baioc/S4PU/docs/figures/prototyped/Fib_16.png

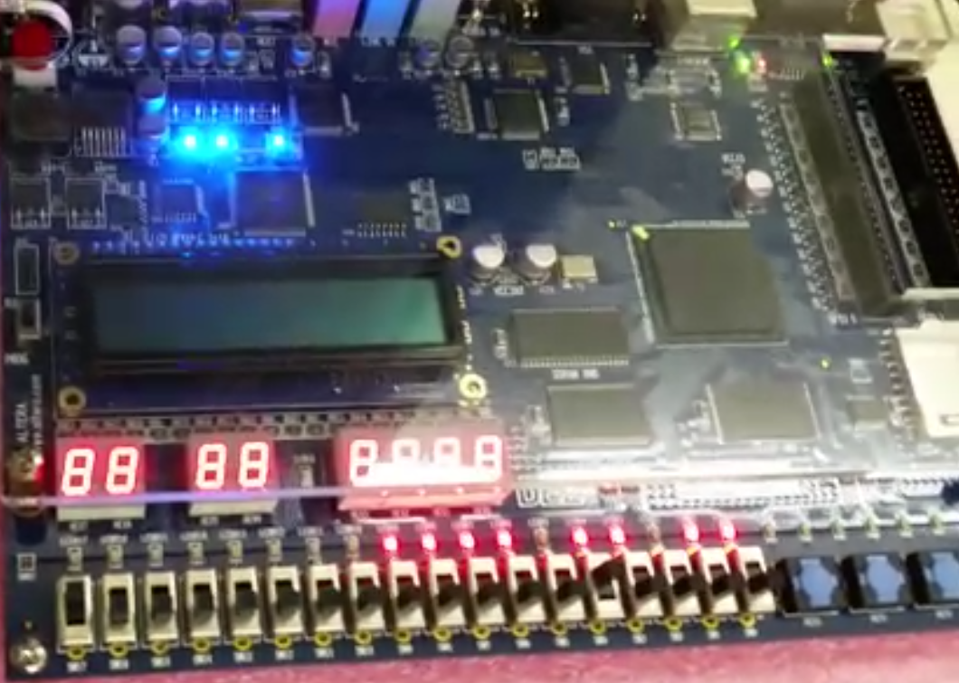
docs/figures/prototyped/Fib_16.png
