baioc/S4PU/docs/figures/prototyped/Fib_13.png

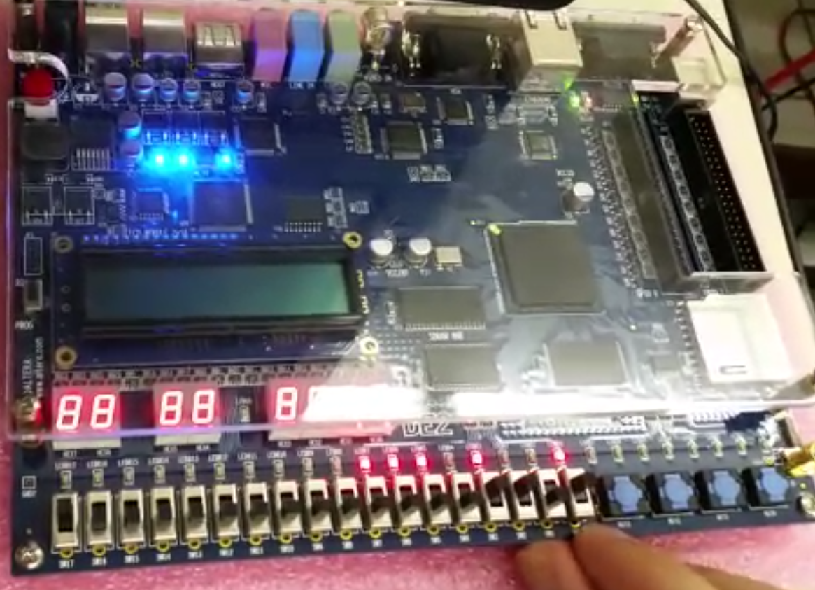
docs/figures/prototyped/Fib_13.png
