baioc/S4PU/docs/figures/draw/ALU.png

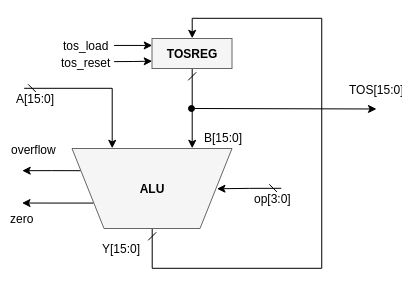
docs/figures/draw/ALU.png
