baioc/S4PU/docs/figures/draw/Datapath.png

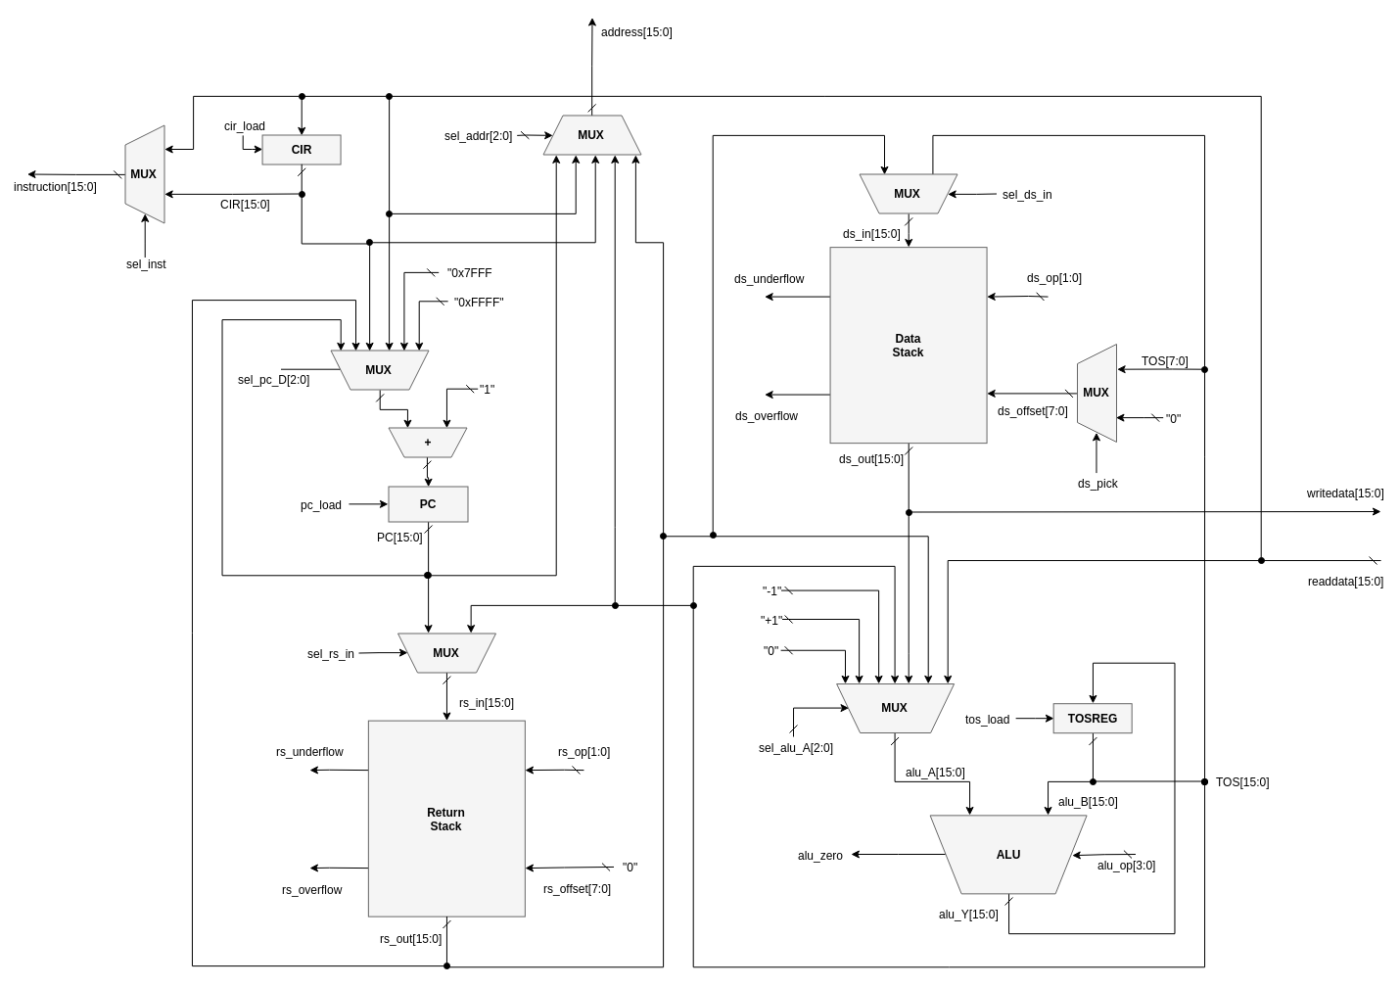
docs/figures/draw/Datapath.png
