baioc/S4PU/docs/figures/draw/FSMD.png

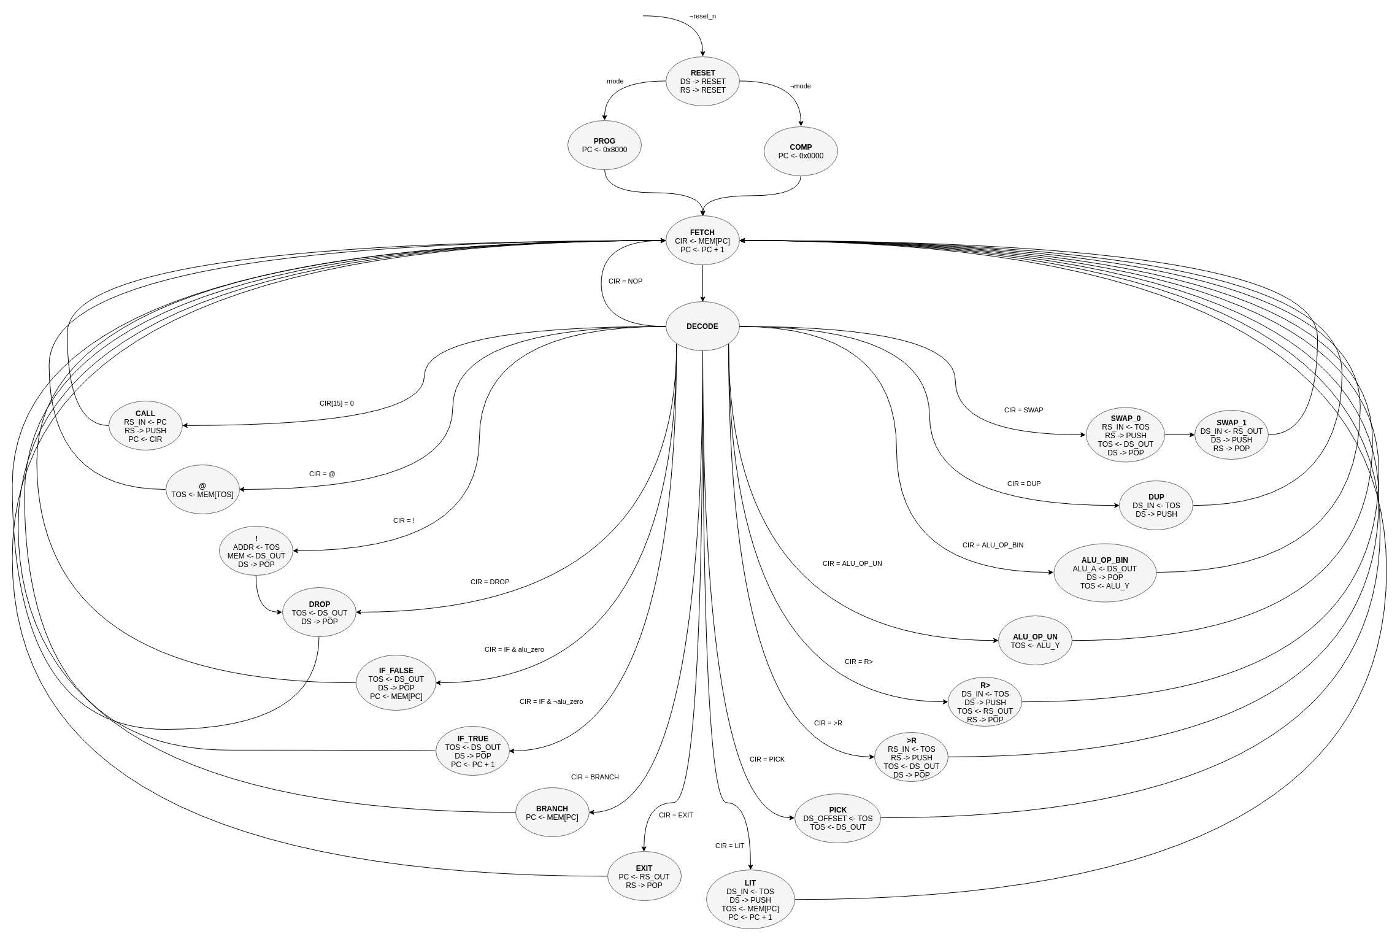
docs/figures/draw/FSMD.png
