baioc/S4PU/docs/figures/draw/Regs.png

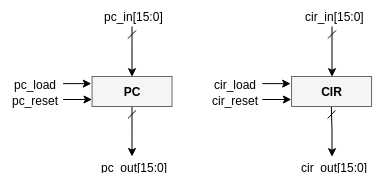
docs/figures/draw/Regs.png
