baioc/S4PU/docs/figures/draw/Stack.png

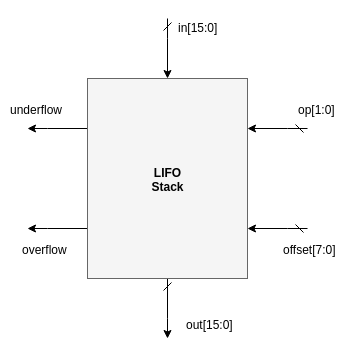
docs/figures/draw/Stack.png
