baioc/S4PU/docs/figures/draw/System.png

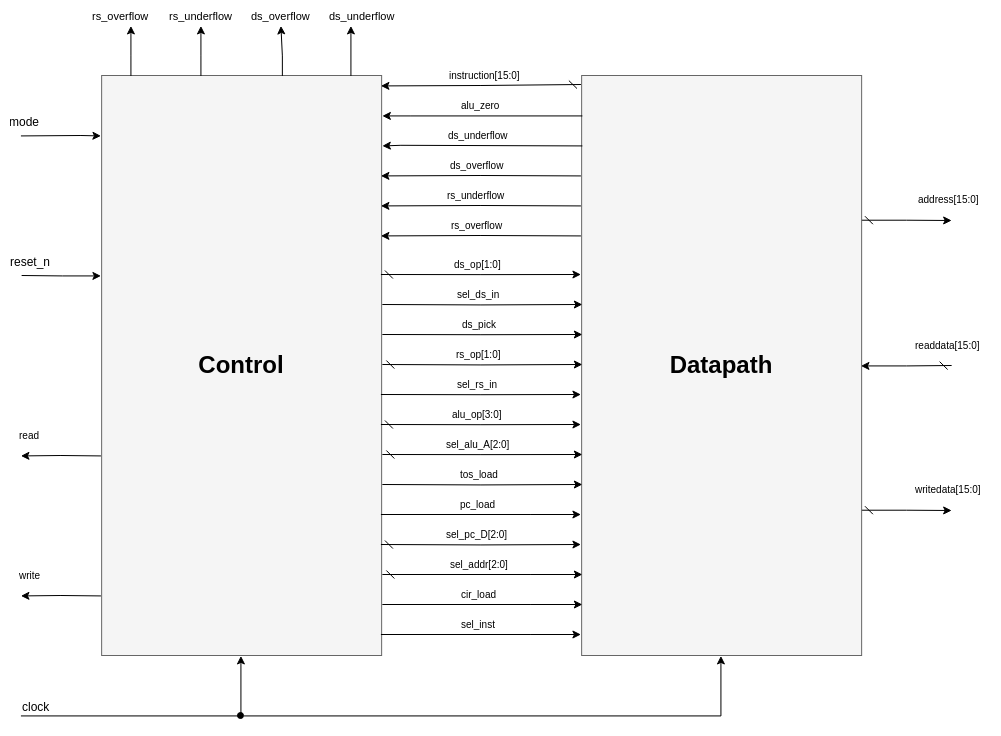
docs/figures/draw/System.png
