baioc/S4PU/docs/figures/misc/S4PU160VHD.png

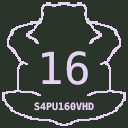
docs/figures/misc/S4PU160VHD.png
