baioc/S4PU/docs/figures/misc/s4pu.png

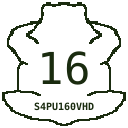
docs/figures/misc/s4pu.png
