baioc/S4PU/docs/figures/simulated/CTRL-SIM-0.png

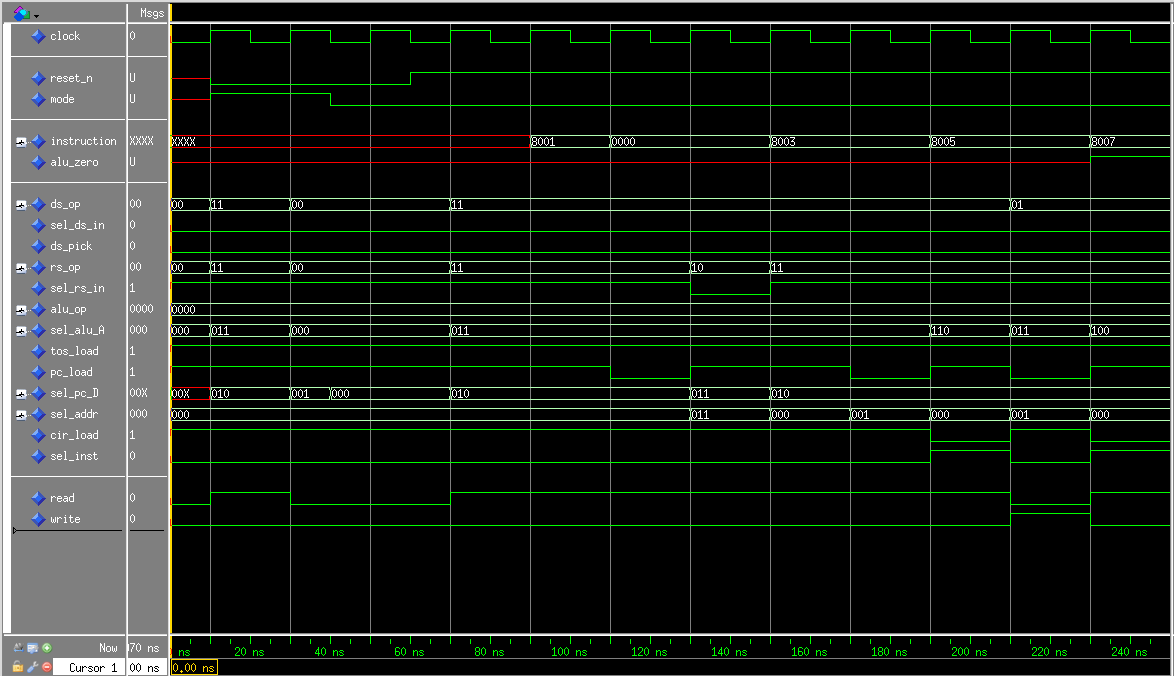
docs/figures/simulated/CTRL-SIM-0.png
