baioc/S4PU/docs/figures/simulated/CTRL-SIM-1.png

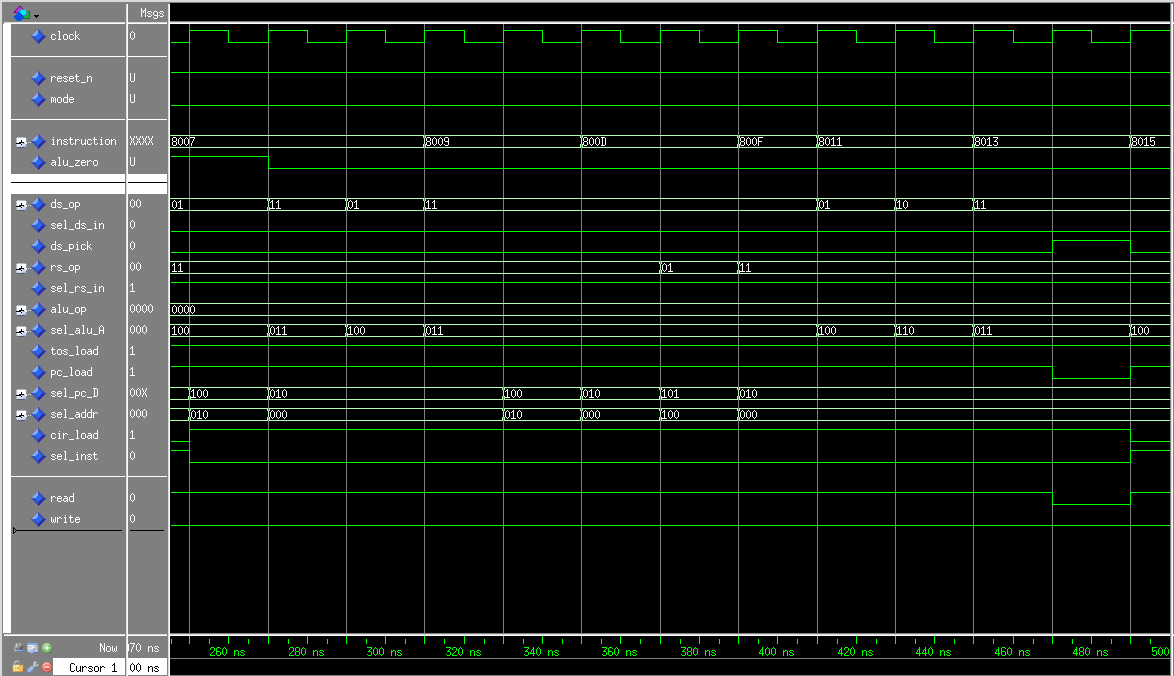
docs/figures/simulated/CTRL-SIM-1.png
