baioc/S4PU/docs/figures/simulated/CTRL-SIM-2.png

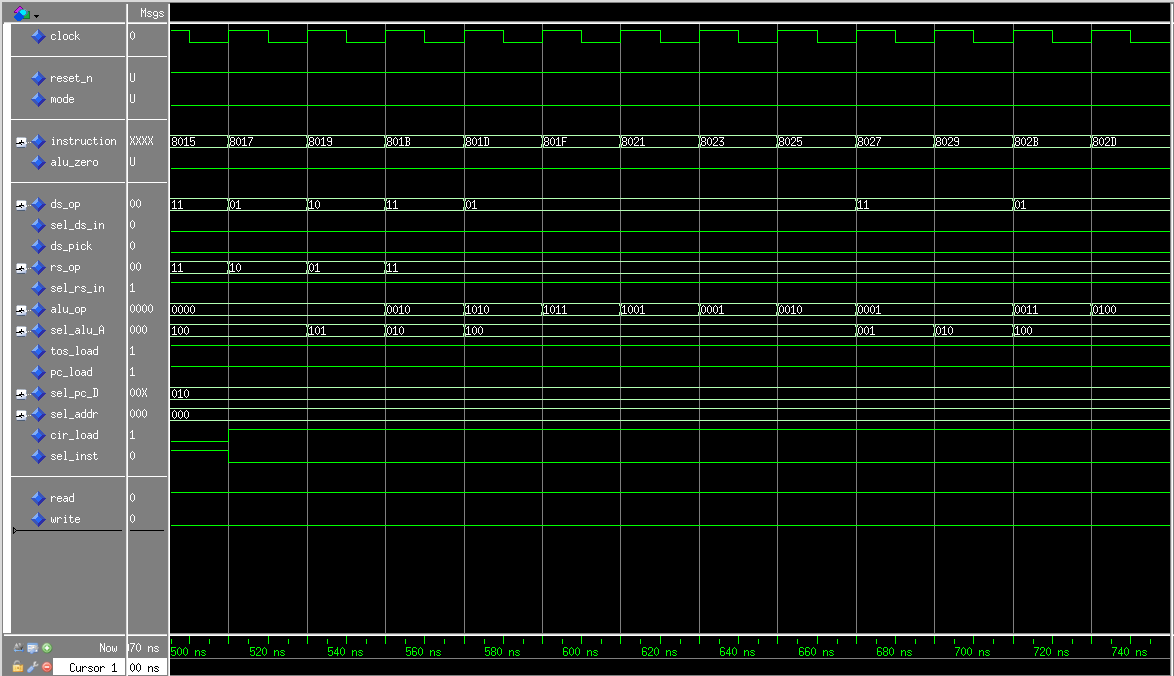
docs/figures/simulated/CTRL-SIM-2.png
