baioc/S4PU/docs/figures/simulated/CTRL-SIM-3.png

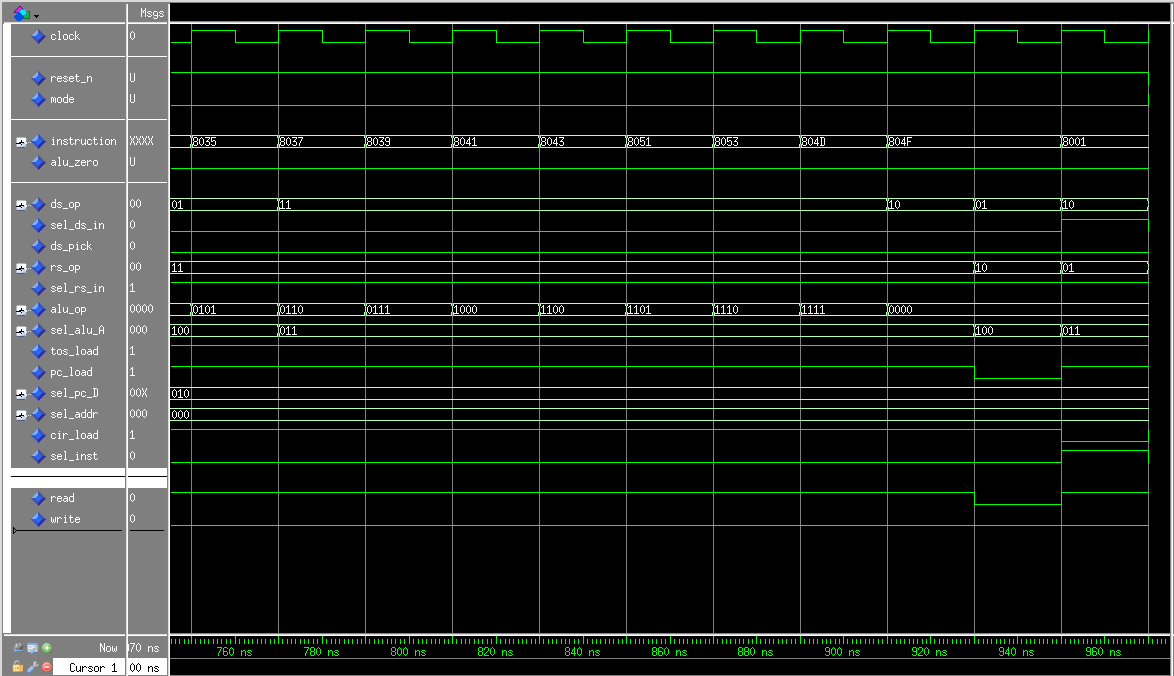
docs/figures/simulated/CTRL-SIM-3.png
