baioc/S4PU/docs/figures/simulated/Fib-SIM-1.png

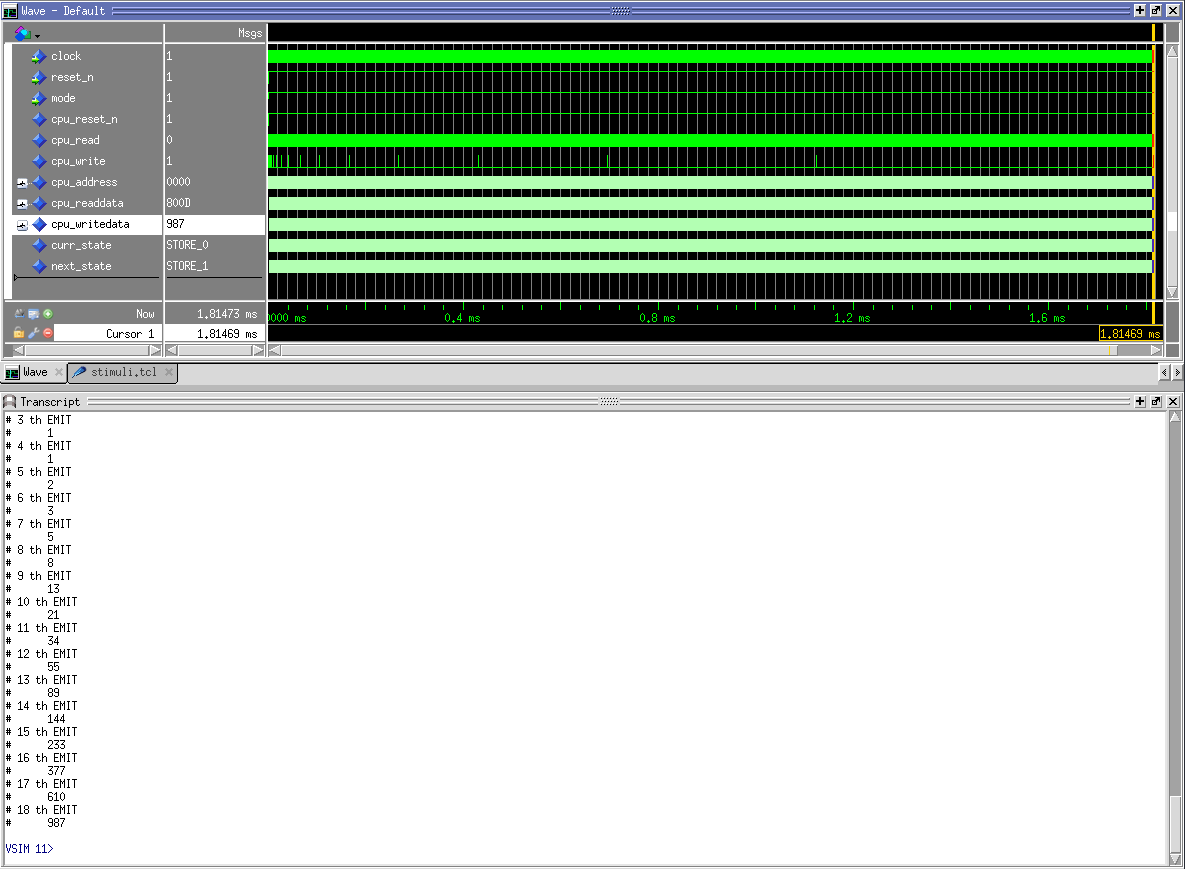
docs/figures/simulated/Fib-SIM-1.png
