baioc/S4PU/docs/figures/simulated/Mux-SIM.png

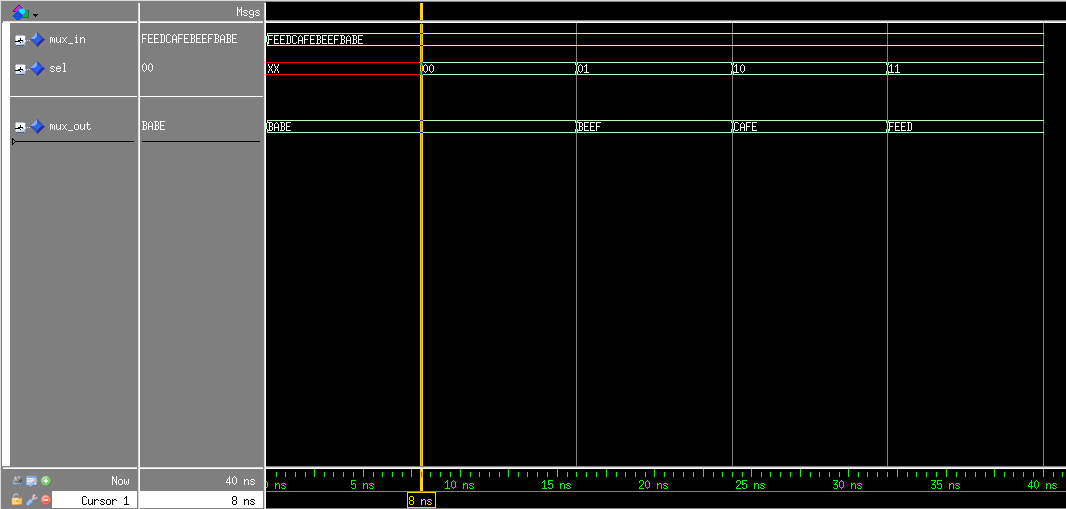
docs/figures/simulated/Mux-SIM.png
