baioc/S4PU/docs/figures/simulated/Reg-SIM.png

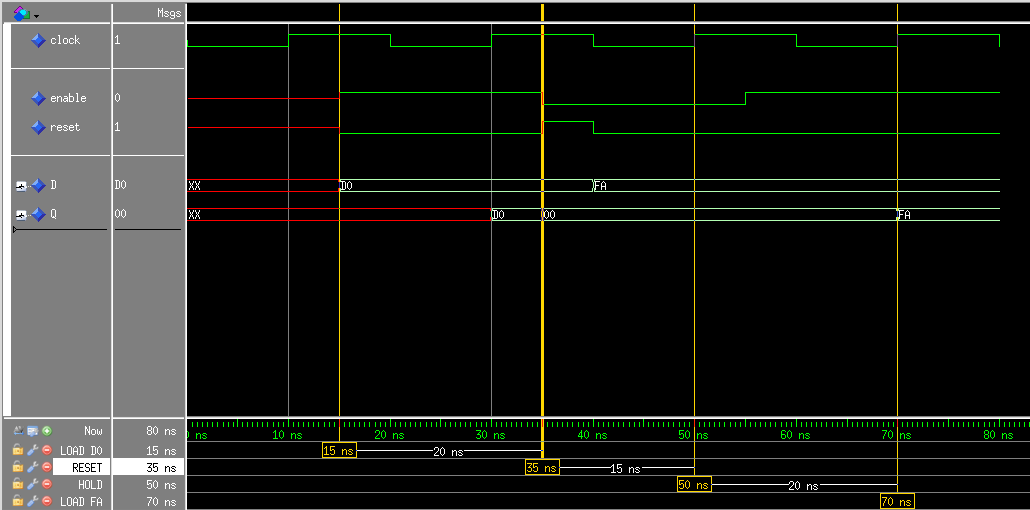
docs/figures/simulated/Reg-SIM.png
