baioc/S4PU/docs/figures/simulated/Stack-SIM-0.png

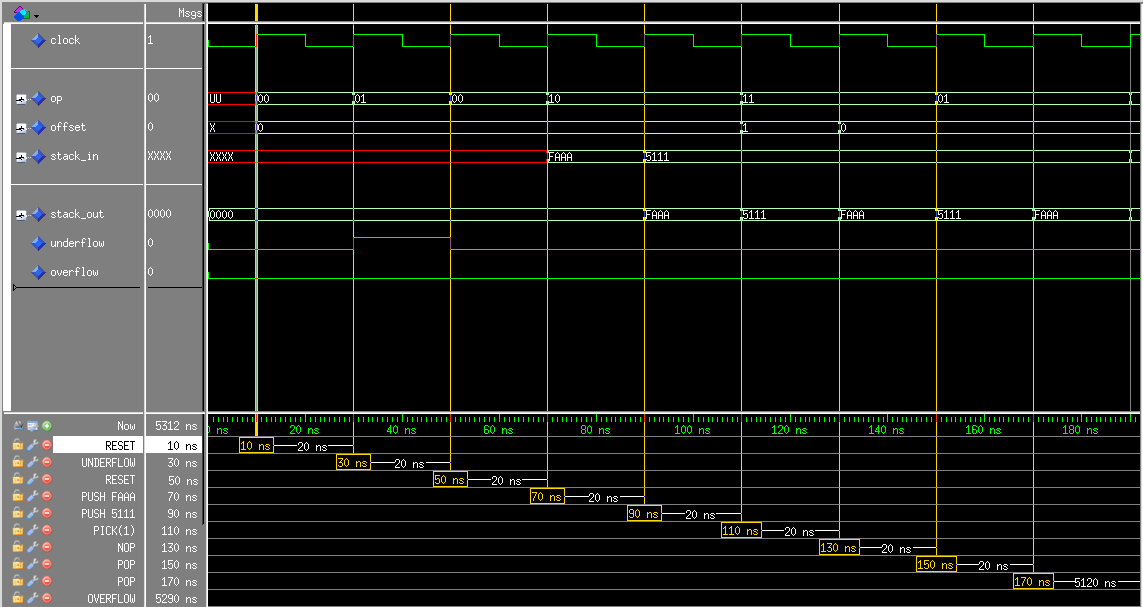
docs/figures/simulated/Stack-SIM-0.png
