baioc/S4PU/docs/figures/simulated/Stack-SIM-1.png

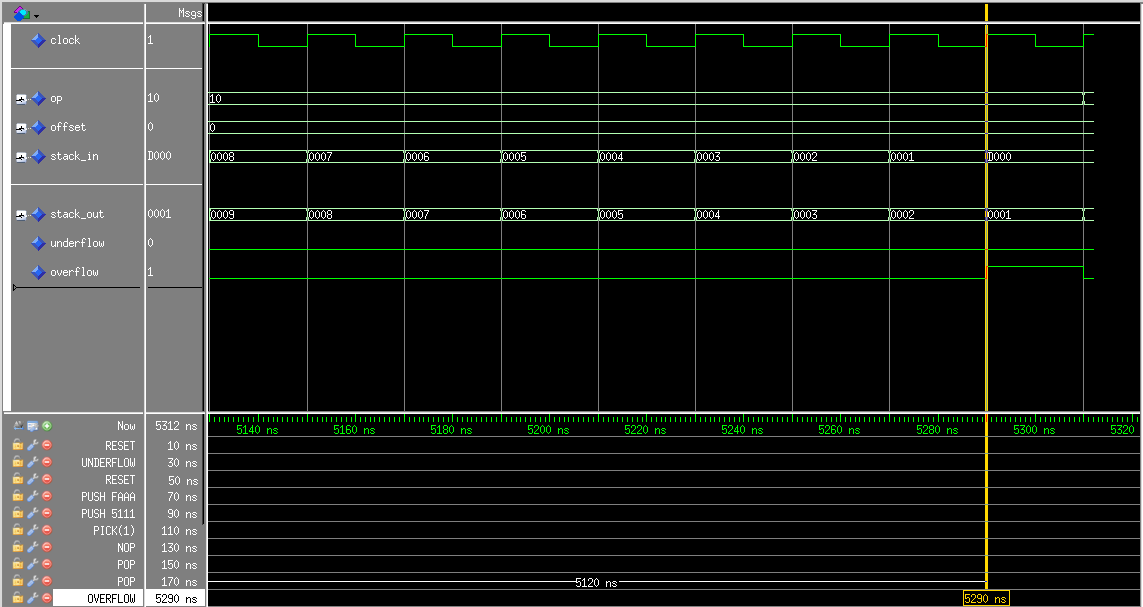
docs/figures/simulated/Stack-SIM-1.png
