baioc/S4PU/docs/figures/sythesized/CPU-RTL.png

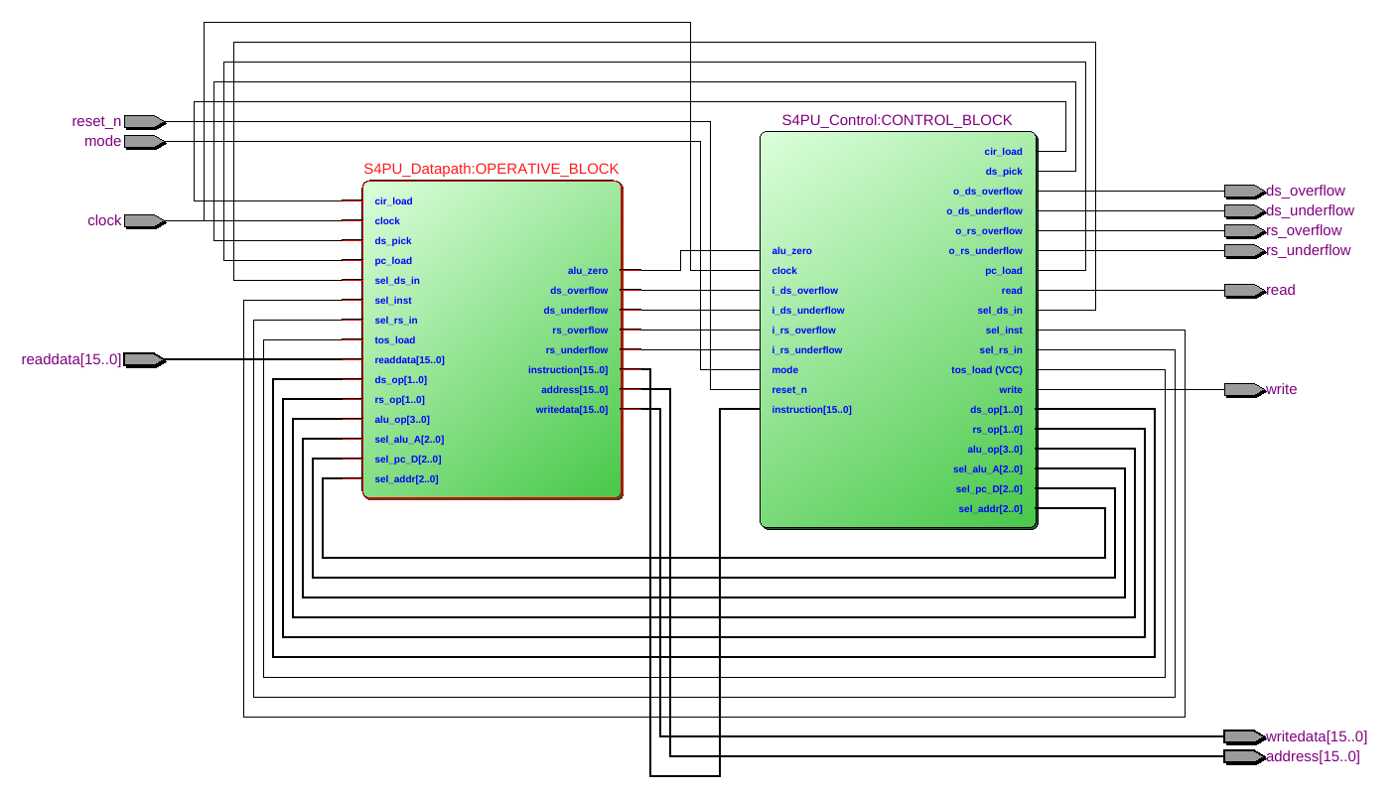
docs/figures/sythesized/CPU-RTL.png
