baioc/S4PU/docs/figures/sythesized/Datapath-RTL.png

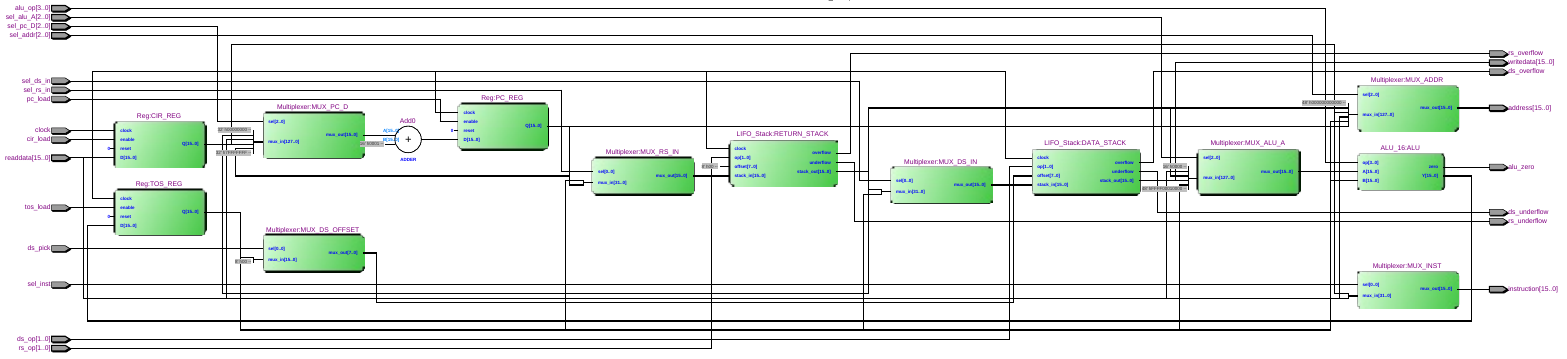
docs/figures/sythesized/Datapath-RTL.png
