baioc/S4PU/docs/figures/sythesized/Mux-RTL.png

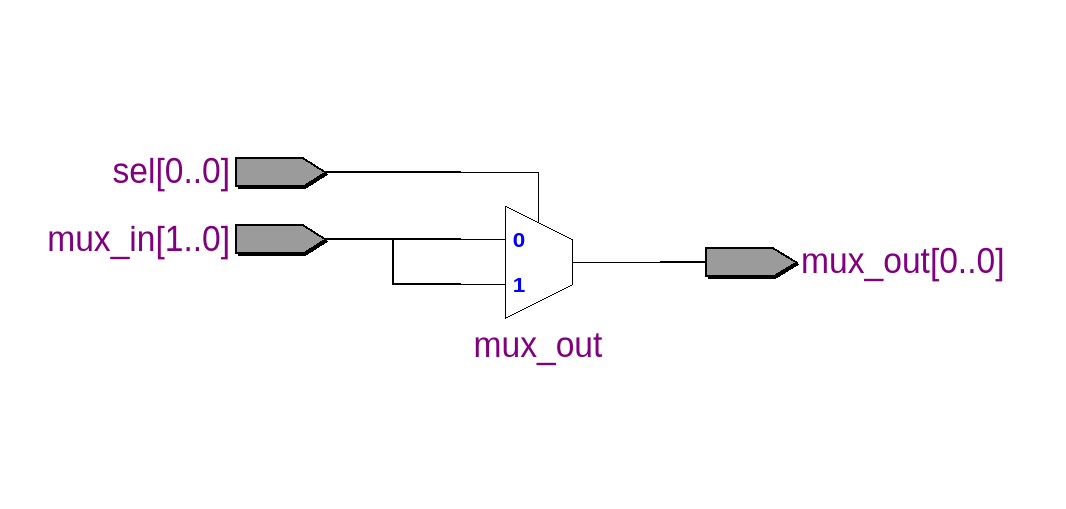
docs/figures/sythesized/Mux-RTL.png
