baioc/S4PU/docs/figures/sythesized/Reg-RTL.png

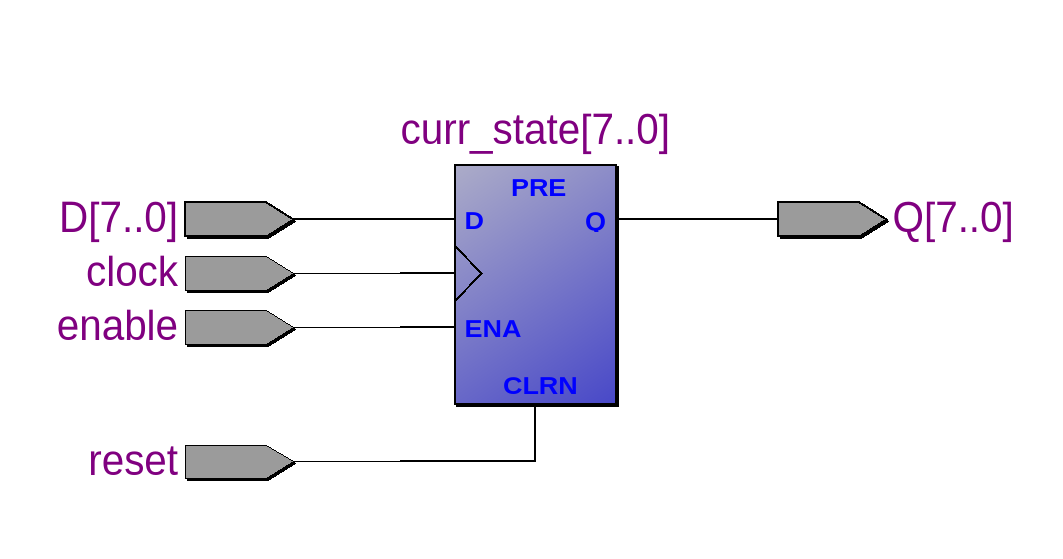
docs/figures/sythesized/Reg-RTL.png
