baioc/S4PU/docs/figures/sythesized/Resources.png

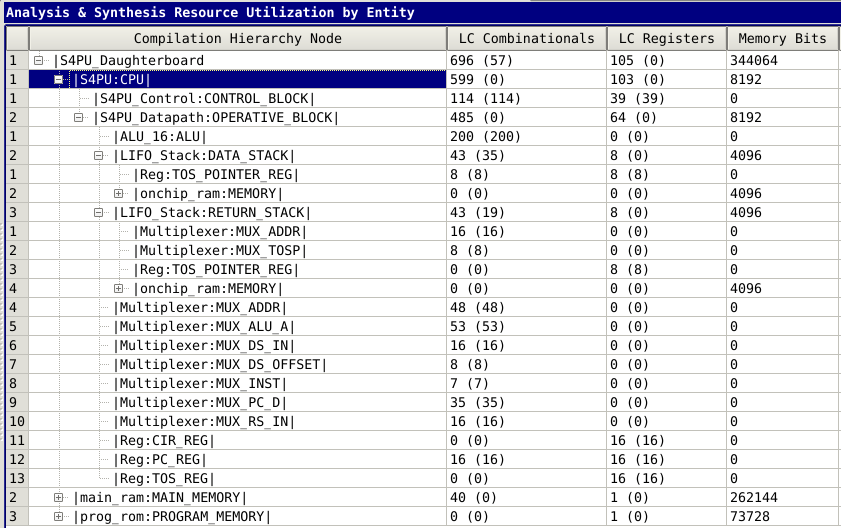
docs/figures/sythesized/Resources.png
