baioc/S4PU/(list of files, cad)

Other CAD files:
quartus/simulation/alu_test/work/alu_16/parallel.psm
quartus/simulation/alu_test/work/alu_16/parallel_16.psm
quartus/simulation/alu_test/work/tb_alu/testbench_16.psm
quartus/simulation/cpu_test/work/alu_16/parallel.psm
quartus/simulation/cpu_test/work/de2/nios2_computer.psm
quartus/simulation/cpu_test/work/de2/stack_computer.psm
quartus/simulation/cpu_test/work/fpga/stack_computer.psm
quartus/simulation/cpu_test/work/lifo_stack/altera_onchip.psm
quartus/simulation/cpu_test/work/lifo_stack/onchip_quartus_ram.psm
quartus/simulation/cpu_test/work/main_ram/syn.psm
quartus/simulation/cpu_test/work/multiplexer/vectorial.psm
quartus/simulation/cpu_test/work/onchip_ram/syn.psm
quartus/simulation/cpu_test/work/prog_rom/syn.psm
quartus/simulation/cpu_test/work/reg/canonical.psm
quartus/simulation/cpu_test/work/s4pu/composite.psm
quartus/simulation/cpu_test/work/s4pu_control/fsm_v0.psm
quartus/simulation/cpu_test/work/s4pu_datapath/operative_v0.psm
quartus/simulation/cpu_test/work/s4pu_daughterboard/embedded_v0.psm
quartus/simulation/ctrl_test/work/s4pu_control/fsm_v0.psm
quartus/simulation/ctrl_test/work/tb_control/testbench.psm
quartus/simulation/mux_test/work/multiplexer/vectorial.psm
quartus/simulation/mux_test/work/tb_mux/testbench_64x16.psm
quartus/simulation/reg_test/work/reg/canonical.psm
quartus/simulation/reg_test/work/tb_reg/testbench.psm
quartus/simulation/stack_test/work/lifo_stack/onchip.psm
quartus/simulation/stack_test/work/multiplexer/vectorial.psm
quartus/simulation/stack_test/work/onchip_ram/syn.psm
quartus/simulation/stack_test/work/reg/canonical.psm
quartus/simulation/stack_test/work/tb_stack/testbench.psm
