baioc/S4PU/docs/figures/sythesized/Control-RTL.pdf

# alu_zero clk reset_n instruction[15..0] A

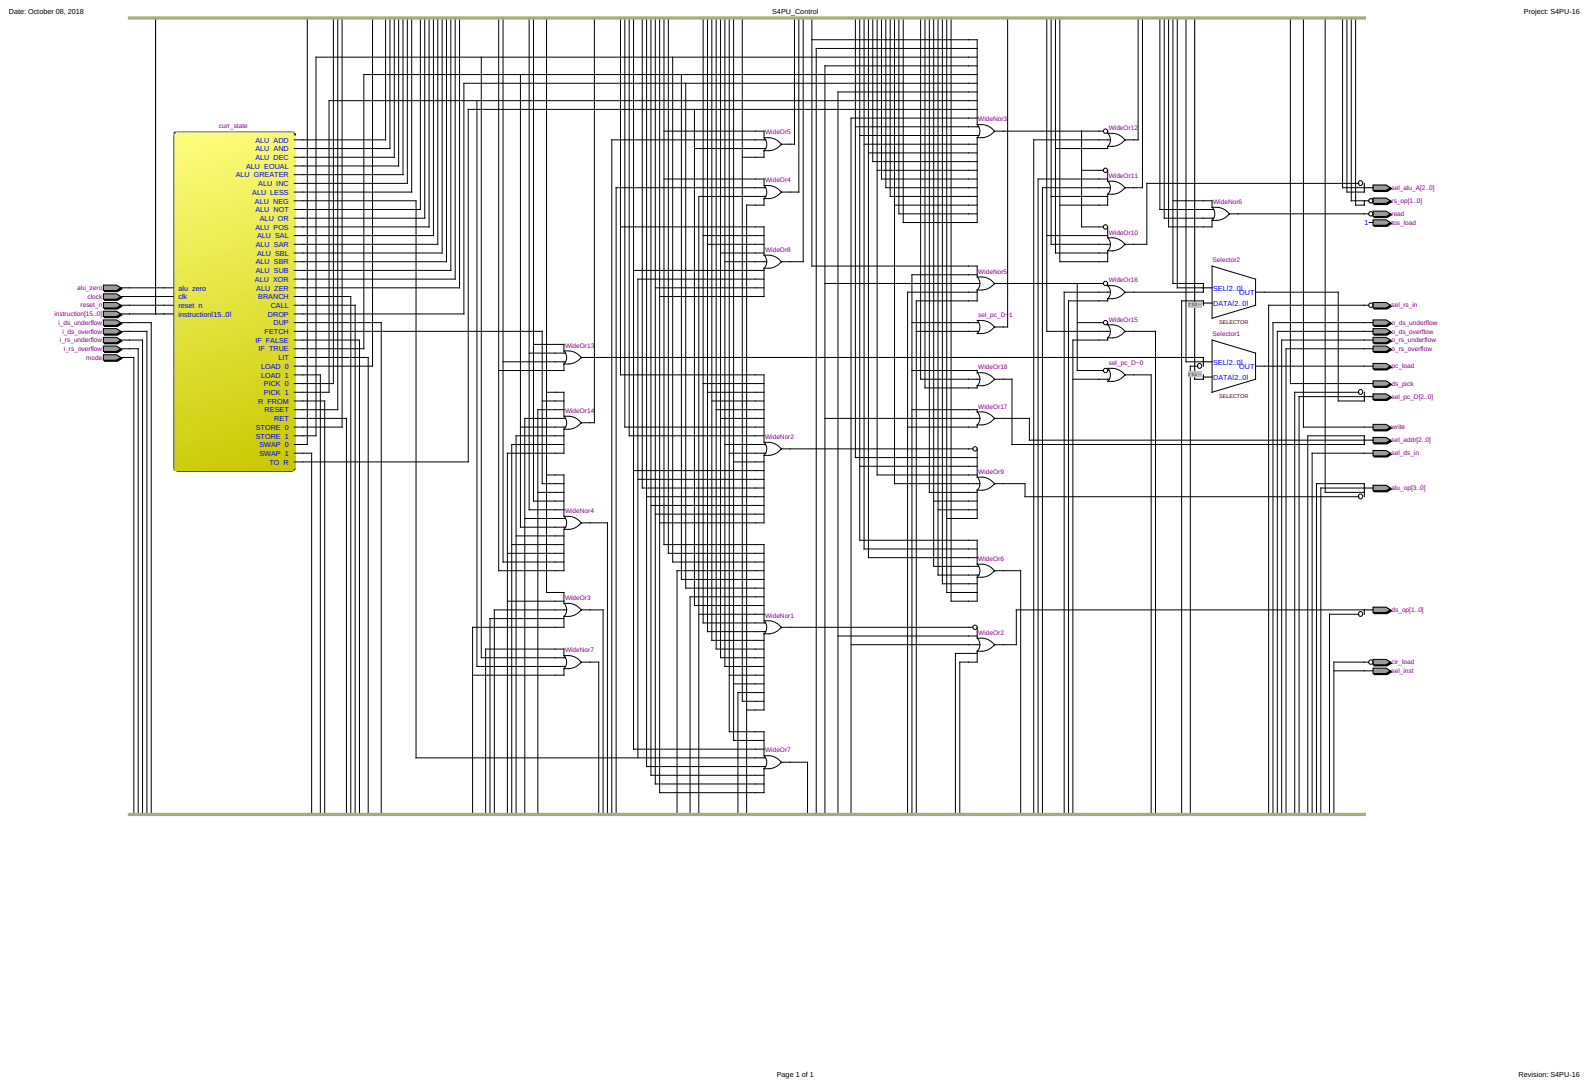
[picture p48: page 1]
ate: Octo; ontrol; Project: S; vision: S; H IF_FALSE IF_TRUELIT LOAD_0 LOAD_1 PICK_0 PICK_1 R_FROM RESET RET STORE_0 STORE_1 SWAP_0 SWAP_1 TO_R; L[2..0] DATA[2..0] OU; 1 sel_pc_D~0 sel_pc_D~1; Selector1 2' h1 --; Selector2 2' h2 -- WideNor1 WideNor2; Wid; Or18 clock reset_n mode; alu_zero i_rs_overflow i_rs_underflow i_ds_overflow i_ds_underflow; sel_; ds_in ds_pick sel_rs_in tos_load pc_load cir_load sel_inst o_rs_overflo; _rs_und; erflo; ds_und; w read write instruction[15..0]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
