baioc/S4PU/quartus/software/fibonacci_bsp/system.h

/*
 * system.h - SOPC Builder system and BSP software package information
 *
 * Machine generated for CPU 'nios2_cpu' in SOPC Builder design 'integration'
 * SOPC Builder design path: ../../integration.sopcinfo
 *
 * Generated: Wed Nov 14 16:52:12 BRST 2018
 */

/*
 * DO NOT MODIFY THIS FILE
 *
 * Changing this file will have subtle consequences
 * which will almost certainly lead to a nonfunctioning
 * system. If you do modify this file, be aware that your
 * changes will be overwritten and lost when this file
 * is generated again.
 *
 * DO NOT MODIFY THIS FILE
 */

/*
 * License Agreement
 *
 * Copyright (c) 2008
 * Altera Corporation, San Jose, California, USA.
 * All rights reserved.
 *
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
 * This agreement shall be governed in all respects by the laws of the State
 * of California and by the laws of the United States of America.
 */

#ifndef __SYSTEM_H_
#define __SYSTEM_H_

/* Include definitions from linker script generator */
#include "linker.h"


/*
 * CPU configuration
 *
 */

#define ALT_CPU_ARCHITECTURE "altera_nios2_qsys"
#define ALT_CPU_BIG_ENDIAN 0
#define ALT_CPU_BREAK_ADDR 0x28820
#define ALT_CPU_CPU_FREQ 50000000u
#define ALT_CPU_CPU_ID_SIZE 1
#define ALT_CPU_CPU_ID_VALUE 0x00000000
#define ALT_CPU_CPU_IMPLEMENTATION "small"
#define ALT_CPU_DATA_ADDR_WIDTH 0x12
#define ALT_CPU_DCACHE_LINE_SIZE 0
#define ALT_CPU_DCACHE_LINE_SIZE_LOG2 0
#define ALT_CPU_DCACHE_SIZE 0
#define ALT_CPU_EXCEPTION_ADDR 0x24020
#define ALT_CPU_FLUSHDA_SUPPORTED
#define ALT_CPU_FREQ 50000000
#define ALT_CPU_HARDWARE_DIVIDE_PRESENT 0
#define ALT_CPU_HARDWARE_MULTIPLY_PRESENT 0
#define ALT_CPU_HARDWARE_MULX_PRESENT 0
#define ALT_CPU_HAS_DEBUG_CORE 1
#define ALT_CPU_HAS_DEBUG_STUB
#define ALT_CPU_HAS_JMPI_INSTRUCTION
#define ALT_CPU_ICACHE_LINE_SIZE 32
#define ALT_CPU_ICACHE_LINE_SIZE_LOG2 5
#define ALT_CPU_ICACHE_SIZE 4096
#define ALT_CPU_INST_ADDR_WIDTH 0x12
#define ALT_CPU_NAME "nios2_cpu"
#define ALT_CPU_RESET_ADDR 0x24000


/*
 * CPU configuration (with legacy prefix - don't use these anymore)
 *
 */

#define NIOS2_BIG_ENDIAN 0
#define NIOS2_BREAK_ADDR 0x28820
#define NIOS2_CPU_FREQ 50000000u
#define NIOS2_CPU_ID_SIZE 1
#define NIOS2_CPU_ID_VALUE 0x00000000
#define NIOS2_CPU_IMPLEMENTATION "small"
#define NIOS2_DATA_ADDR_WIDTH 0x12
#define NIOS2_DCACHE_LINE_SIZE 0
#define NIOS2_DCACHE_LINE_SIZE_LOG2 0
#define NIOS2_DCACHE_SIZE 0
#define NIOS2_EXCEPTION_ADDR 0x24020
#define NIOS2_FLUSHDA_SUPPORTED
#define NIOS2_HARDWARE_DIVIDE_PRESENT 0
#define NIOS2_HARDWARE_MULTIPLY_PRESENT 0
#define NIOS2_HARDWARE_MULX_PRESENT 0
#define NIOS2_HAS_DEBUG_CORE 1
#define NIOS2_HAS_DEBUG_STUB
#define NIOS2_HAS_JMPI_INSTRUCTION
#define NIOS2_ICACHE_LINE_SIZE 32
#define NIOS2_ICACHE_LINE_SIZE_LOG2 5
#define NIOS2_ICACHE_SIZE 4096
#define NIOS2_INST_ADDR_WIDTH 0x12
#define NIOS2_RESET_ADDR 0x24000


/*
 * Define for each module class mastered by the CPU
 *
 */

#define __ALTERA_AVALON_JTAG_UART
#define __ALTERA_AVALON_ONCHIP_MEMORY2
#define __ALTERA_AVALON_PIO
#define __ALTERA_AVALON_SYSID_QSYS
#define __ALTERA_NIOS2_QSYS
#define __S4PU_DAUGHTERBOARD_QSYS


/*
 * System configuration
 *
 */

#define ALT_DEVICE_FAMILY "Cyclone II"
#define ALT_ENHANCED_INTERRUPT_API_PRESENT
#define ALT_IRQ_BASE NULL
#define ALT_LOG_PORT "/dev/null"
#define ALT_LOG_PORT_BASE 0x0
#define ALT_LOG_PORT_DEV null
#define ALT_LOG_PORT_TYPE ""
#define ALT_NUM_EXTERNAL_INTERRUPT_CONTROLLERS 0
#define ALT_NUM_INTERNAL_INTERRUPT_CONTROLLERS 1
#define ALT_NUM_INTERRUPT_CONTROLLERS 1
#define ALT_STDERR "/dev/jtag_uart"
#define ALT_STDERR_BASE 0x29018
#define ALT_STDERR_DEV jtag_uart
#define ALT_STDERR_IS_JTAG_UART
#define ALT_STDERR_PRESENT
#define ALT_STDERR_TYPE "altera_avalon_jtag_uart"
#define ALT_STDIN "/dev/jtag_uart"
#define ALT_STDIN_BASE 0x29018
#define ALT_STDIN_DEV jtag_uart
#define ALT_STDIN_IS_JTAG_UART
#define ALT_STDIN_PRESENT
#define ALT_STDIN_TYPE "altera_avalon_jtag_uart"
#define ALT_STDOUT "/dev/jtag_uart"
#define ALT_STDOUT_BASE 0x29018
#define ALT_STDOUT_DEV jtag_uart
#define ALT_STDOUT_IS_JTAG_UART
#define ALT_STDOUT_PRESENT
#define ALT_STDOUT_TYPE "altera_avalon_jtag_uart"
#define ALT_SYSTEM_NAME "integration"


/*
 * hal configuration
 *
 */

#define ALT_MAX_FD 4
#define ALT_SYS_CLK none
#define ALT_TIMESTAMP_CLK none


/*
 * jtag_uart configuration
 *
 */

#define ALT_MODULE_CLASS_jtag_uart altera_avalon_jtag_uart
#define JTAG_UART_BASE 0x29018
#define JTAG_UART_IRQ 0
#define JTAG_UART_IRQ_INTERRUPT_CONTROLLER_ID 0
#define JTAG_UART_NAME "/dev/jtag_uart"
#define JTAG_UART_READ_DEPTH 64
#define JTAG_UART_READ_THRESHOLD 8
#define JTAG_UART_SPAN 8
#define JTAG_UART_TYPE "altera_avalon_jtag_uart"
#define JTAG_UART_WRITE_DEPTH 64
#define JTAG_UART_WRITE_THRESHOLD 8


/*
 * onchip_mem_nios2 configuration
 *
 */

#define ALT_MODULE_CLASS_onchip_mem_nios2 altera_avalon_onchip_memory2
#define ONCHIP_MEM_NIOS2_ALLOW_IN_SYSTEM_MEMORY_CONTENT_EDITOR 0
#define ONCHIP_MEM_NIOS2_ALLOW_MRAM_SIM_CONTENTS_ONLY_FILE 0
#define ONCHIP_MEM_NIOS2_BASE 0x24000
#define ONCHIP_MEM_NIOS2_CONTENTS_INFO ""
#define ONCHIP_MEM_NIOS2_DUAL_PORT 0
#define ONCHIP_MEM_NIOS2_GUI_RAM_BLOCK_TYPE "AUTO"
#define ONCHIP_MEM_NIOS2_INIT_CONTENTS_FILE "integration_onchip_mem_nios2"
#define ONCHIP_MEM_NIOS2_INIT_MEM_CONTENT 1
#define ONCHIP_MEM_NIOS2_INSTANCE_ID "NIOS"
#define ONCHIP_MEM_NIOS2_IRQ -1
#define ONCHIP_MEM_NIOS2_IRQ_INTERRUPT_CONTROLLER_ID -1
#define ONCHIP_MEM_NIOS2_NAME "/dev/onchip_mem_nios2"
#define ONCHIP_MEM_NIOS2_NON_DEFAULT_INIT_FILE_ENABLED 0
#define ONCHIP_MEM_NIOS2_RAM_BLOCK_TYPE "AUTO"
#define ONCHIP_MEM_NIOS2_READ_DURING_WRITE_MODE "DONT_CARE"
#define ONCHIP_MEM_NIOS2_SINGLE_CLOCK_OP 0
#define ONCHIP_MEM_NIOS2_SIZE_MULTIPLE 1
#define ONCHIP_MEM_NIOS2_SIZE_VALUE 10240
#define ONCHIP_MEM_NIOS2_SPAN 10240
#define ONCHIP_MEM_NIOS2_TYPE "altera_avalon_onchip_memory2"
#define ONCHIP_MEM_NIOS2_WRITABLE 1


/*
 * pio_led configuration
 *
 */

#define ALT_MODULE_CLASS_pio_led altera_avalon_pio
#define PIO_LED_BASE 0x29000
#define PIO_LED_BIT_CLEARING_EDGE_REGISTER 0
#define PIO_LED_BIT_MODIFYING_OUTPUT_REGISTER 0
#define PIO_LED_CAPTURE 0
#define PIO_LED_DATA_WIDTH 16
#define PIO_LED_DO_TEST_BENCH_WIRING 0
#define PIO_LED_DRIVEN_SIM_VALUE 0
#define PIO_LED_EDGE_TYPE "NONE"
#define PIO_LED_FREQ 50000000
#define PIO_LED_HAS_IN 0
#define PIO_LED_HAS_OUT 1
#define PIO_LED_HAS_TRI 0
#define PIO_LED_IRQ -1
#define PIO_LED_IRQ_INTERRUPT_CONTROLLER_ID -1
#define PIO_LED_IRQ_TYPE "NONE"
#define PIO_LED_NAME "/dev/pio_led"
#define PIO_LED_RESET_VALUE 12598
#define PIO_LED_SPAN 16
#define PIO_LED_TYPE "altera_avalon_pio"


/*
 * s4pu_cpu configuration
 *
 */

#define ALT_MODULE_CLASS_s4pu_cpu s4pu_daughterboard_qsys
#define S4PU_CPU_BASE 0x0
#define S4PU_CPU_IRQ -1
#define S4PU_CPU_IRQ_INTERRUPT_CONTROLLER_ID -1
#define S4PU_CPU_NAME "/dev/s4pu_cpu"
#define S4PU_CPU_SPAN 131072
#define S4PU_CPU_TYPE "s4pu_daughterboard_qsys"


/*
 * sysid configuration
 *
 */

#define ALT_MODULE_CLASS_sysid altera_avalon_sysid_qsys
#define SYSID_BASE 0x29010
#define SYSID_ID 1395937365
#define SYSID_IRQ -1
#define SYSID_IRQ_INTERRUPT_CONTROLLER_ID -1
#define SYSID_NAME "/dev/sysid"
#define SYSID_SPAN 8
#define SYSID_TIMESTAMP 1542221001
#define SYSID_TYPE "altera_avalon_sysid_qsys"

#endif /* __SYSTEM_H_ */
