baioc/S4PU/quartus/qsys/synthesis/integration.vhd

-- integration.vhd

-- Generated using ACDS version 13.0sp1 232 at 2018.11.14.16:43:24

library IEEE;
use IEEE.std_logic_1164.all;
use IEEE.numeric_std.all;

entity integration is
	port (
		clk_clk       : in  std_logic                     := '0'; --   clk.clk
		reset_reset_n : in  std_logic                     := '0'; -- reset.reset_n
		led_export    : out std_logic_vector(15 downto 0);        --   led.export
		s4pu_export   : in  std_logic                     := '0'  --  s4pu.export
	);
end entity integration;

architecture rtl of integration is
	component integration_nios2_cpu is
		port (
			clk                                   : in  std_logic                     := 'X';             -- clk
			reset_n                               : in  std_logic                     := 'X';             -- reset_n
			d_address                             : out std_logic_vector(17 downto 0);                    -- address
			d_byteenable                          : out std_logic_vector(3 downto 0);                     -- byteenable
			d_read                                : out std_logic;                                        -- read
			d_readdata                            : in  std_logic_vector(31 downto 0) := (others => 'X'); -- readdata
			d_waitrequest                         : in  std_logic                     := 'X';             -- waitrequest
			d_write                               : out std_logic;                                        -- write
			d_writedata                           : out std_logic_vector(31 downto 0);                    -- writedata
			jtag_debug_module_debugaccess_to_roms : out std_logic;                                        -- debugaccess
			i_address                             : out std_logic_vector(17 downto 0);                    -- address
			i_read                                : out std_logic;                                        -- read
			i_readdata                            : in  std_logic_vector(31 downto 0) := (others => 'X'); -- readdata
			i_waitrequest                         : in  std_logic                     := 'X';             -- waitrequest
			i_readdatavalid                       : in  std_logic                     := 'X';             -- readdatavalid
			d_irq                                 : in  std_logic_vector(31 downto 0) := (others => 'X'); -- irq
			jtag_debug_module_resetrequest        : out std_logic;                                        -- reset
			jtag_debug_module_address             : in  std_logic_vector(8 downto 0)  := (others => 'X'); -- address
			jtag_debug_module_byteenable          : in  std_logic_vector(3 downto 0)  := (others => 'X'); -- byteenable
			jtag_debug_module_debugaccess         : in  std_logic                     := 'X';             -- debugaccess
			jtag_debug_module_read                : in  std_logic                     := 'X';             -- read
			jtag_debug_module_readdata            : out std_logic_vector(31 downto 0);                    -- readdata
			jtag_debug_module_waitrequest         : out std_logic;                                        -- waitrequest
			jtag_debug_module_write               : in  std_logic                     := 'X';             -- write
			jtag_debug_module_writedata           : in  std_logic_vector(31 downto 0) := (others => 'X'); -- writedata
			no_ci_readra                          : out std_logic                                         -- readra
		);
	end component integration_nios2_cpu;

	component integration_onchip_mem_nios2 is
		port (
			clk        : in  std_logic                     := 'X';             -- clk
			address    : in  std_logic_vector(11 downto 0) := (others => 'X'); -- address
			clken      : in  std_logic                     := 'X';             -- clken
			chipselect : in  std_logic                     := 'X';             -- chipselect
			write      : in  std_logic                     := 'X';             -- write
			readdata   : out std_logic_vector(31 downto 0);                    -- readdata
			writedata  : in  std_logic_vector(31 downto 0) := (others => 'X'); -- writedata
			byteenable : in  std_logic_vector(3 downto 0)  := (others => 'X'); -- byteenable
			reset      : in  std_logic                     := 'X';             -- reset
			reset_req  : in  std_logic                     := 'X'              -- reset_req
		);
	end component integration_onchip_mem_nios2;

	component integration_jtag_uart is
		port (
			clk            : in  std_logic                     := 'X';             -- clk
			rst_n          : in  std_logic                     := 'X';             -- reset_n
			av_chipselect  : in  std_logic                     := 'X';             -- chipselect
			av_address     : in  std_logic                     := 'X';             -- address
			av_read_n      : in  std_logic                     := 'X';             -- read_n
			av_readdata    : out std_logic_vector(31 downto 0);                    -- readdata
			av_write_n     : in  std_logic                     := 'X';             -- write_n
			av_writedata   : in  std_logic_vector(31 downto 0) := (others => 'X'); -- writedata
			av_waitrequest : out std_logic;                                        -- waitrequest
			av_irq         : out std_logic                                         -- irq
		);
	end component integration_jtag_uart;

	component integration_sysid is
		port (
			clock    : in  std_logic                     := 'X'; -- clk
			reset_n  : in  std_logic                     := 'X'; -- reset_n
			readdata : out std_logic_vector(31 downto 0);        -- readdata
			address  : in  std_logic                     := 'X'  -- address
		);
	end component integration_sysid;

	component integration_pio_led is
		port (
			clk        : in  std_logic                     := 'X';             -- clk
			reset_n    : in  std_logic                     := 'X';             -- reset_n
			address    : in  std_logic_vector(1 downto 0)  := (others => 'X'); -- address
			write_n    : in  std_logic                     := 'X';             -- write_n
			writedata  : in  std_logic_vector(31 downto 0) := (others => 'X'); -- writedata
			chipselect : in  std_logic                     := 'X';             -- chipselect
			readdata   : out std_logic_vector(31 downto 0);                    -- readdata
			out_port   : out std_logic_vector(15 downto 0)                     -- export
		);
	end component integration_pio_led;

	component S4PU_Daughterboard is
		generic (
			ARCH : positive := 16
		);
		port (
			clock         : in  std_logic                     := 'X';             -- clk
			reset_n       : in  std_logic                     := 'X';             -- reset_n
			mode          : in  std_logic                     := 'X';             -- export
			ext_write     : in  std_logic                     := 'X';             -- write
			ext_address   : in  std_logic_vector(15 downto 0) := (others => 'X'); -- address
			ext_writedata : in  std_logic_vector(15 downto 0) := (others => 'X'); -- writedata
			ext_readdata  : out std_logic_vector(15 downto 0)                     -- readdata
		);
	end component S4PU_Daughterboard;

	component altera_merlin_master_agent is
		generic (
			PKT_PROTECTION_H          : integer := 80;
			PKT_PROTECTION_L          : integer := 80;
			PKT_BEGIN_BURST           : integer := 81;
			PKT_BURSTWRAP_H           : integer := 79;
			PKT_BURSTWRAP_L           : integer := 77;
			PKT_BURST_SIZE_H          : integer := 86;
			PKT_BURST_SIZE_L          : integer := 84;
			PKT_BURST_TYPE_H          : integer := 94;
			PKT_BURST_TYPE_L          : integer := 93;
			PKT_BYTE_CNT_H            : integer := 76;
			PKT_BYTE_CNT_L            : integer := 74;
			PKT_ADDR_H                : integer := 73;
			PKT_ADDR_L                : integer := 42;
			PKT_TRANS_COMPRESSED_READ : integer := 41;
			PKT_TRANS_POSTED          : integer := 40;
			PKT_TRANS_WRITE           : integer := 39;
			PKT_TRANS_READ            : integer := 38;
			PKT_TRANS_LOCK            : integer := 82;
			PKT_TRANS_EXCLUSIVE       : integer := 83;
			PKT_DATA_H                : integer := 37;
			PKT_DATA_L                : integer := 6;
			PKT_BYTEEN_H              : integer := 5;
			PKT_BYTEEN_L              : integer := 2;
			PKT_SRC_ID_H              : integer := 1;
			PKT_SRC_ID_L              : integer := 1;
			PKT_DEST_ID_H             : integer := 0;
			PKT_DEST_ID_L             : integer := 0;
			PKT_THREAD_ID_H           : integer := 88;
			PKT_THREAD_ID_L           : integer := 87;
			PKT_CACHE_H               : integer := 92;
			PKT_CACHE_L               : integer := 89;
			PKT_DATA_SIDEBAND_H       : integer := 105;
			PKT_DATA_SIDEBAND_L       : integer := 98;
			PKT_QOS_H                 : integer := 109;
			PKT_QOS_L                 : integer := 106;
			PKT_ADDR_SIDEBAND_H       : integer := 97;
			PKT_ADDR_SIDEBAND_L       : integer := 93;
			PKT_RESPONSE_STATUS_H     : integer := 111;
			PKT_RESPONSE_STATUS_L     : integer := 110;
			ST_DATA_W                 : integer := 112;
			ST_CHANNEL_W              : integer := 1;
			AV_BURSTCOUNT_W           : integer := 3;
			SUPPRESS_0_BYTEEN_RSP     : integer := 1;
			ID                        : integer := 1;
			BURSTWRAP_VALUE           : integer := 4;
			CACHE_VALUE               : integer := 0;
			SECURE_ACCESS_BIT         : integer := 1;
			USE_READRESPONSE          : integer := 0;
			USE_WRITERESPONSE         : integer := 0
		);
		port (
			clk                     : in  std_logic                     := 'X';             -- clk
			reset                   : in  std_logic                     := 'X';             -- reset
			av_address              : in  std_logic_vector(17 downto 0) := (others => 'X'); -- address
			av_write                : in  std_logic                     := 'X';             -- write
			av_read                 : in  std_logic                     := 'X';             -- read
			av_writedata            : in  std_logic_vector(31 downto 0) := (others => 'X'); -- writedata
			av_readdata             : out std_logic_vector(31 downto 0);                    -- readdata
			av_waitrequest          : out std_logic;                                        -- waitrequest
			av_readdatavalid        : out std_logic;                                        -- readdatavalid
			av_byteenable           : in  std_logic_vector(3 downto 0)  := (others => 'X'); -- byteenable
			av_burstcount           : in  std_logic_vector(2 downto 0)  := (others => 'X'); -- burstcount
			av_debugaccess          : in  std_logic                     := 'X';             -- debugaccess
			av_lock                 : in  std_logic                     := 'X';             -- lock
			cp_valid                : out std_logic;                                        -- valid
			cp_data                 : out std_logic_vector(90 downto 0);                    -- data
			cp_startofpacket        : out std_logic;                                        -- startofpacket
			cp_endofpacket          : out std_logic;                                        -- endofpacket
			cp_ready                : in  std_logic                     := 'X';             -- ready
			rp_valid                : in  std_logic                     := 'X';             -- valid
			rp_data                 : in  std_logic_vector(90 downto 0) := (others => 'X'); -- data
			rp_channel              : in  std_logic_vector(5 downto 0)  := (others => 'X'); -- channel
			rp_startofpacket        : in  std_logic                     := 'X';             -- startofpacket
			rp_endofpacket          : in  std_logic                     := 'X';             -- endofpacket
			rp_ready                : out std_logic;                                        -- ready
			av_response             : out std_logic_vector(1 downto 0);                     -- response
			av_writeresponserequest : in  std_logic                     := 'X';             -- writeresponserequest
			av_writeresponsevalid   : out std_logic                                         -- writeresponsevalid
		);
	end component altera_merlin_master_agent;

	component integration_addr_router is
		port (
			sink_ready         : out std_logic;                                        -- ready
			sink_valid         : in  std_logic                     := 'X';             -- valid
			sink_data          : in  std_logic_vector(90 downto 0) := (others => 'X'); -- data
			sink_startofpacket : in  std_logic                     := 'X';             -- startofpacket
			sink_endofpacket   : in  std_logic                     := 'X';             -- endofpacket
			clk                : in  std_logic                     := 'X';             -- clk
			reset              : in  std_logic                     := 'X';             -- reset
			src_ready          : in  std_logic                     := 'X';             -- ready
			src_valid          : out std_logic;                                        -- valid
			src_data           : out std_logic_vector(90 downto 0);                    -- data
			src_channel        : out std_logic_vector(5 downto 0);                     -- channel
			src_startofpacket  : out std_logic;                                        -- startofpacket
			src_endofpacket    : out std_logic                                         -- endofpacket
		);
	end component integration_addr_router;

	component integration_addr_router_001 is
		port (
			sink_ready         : out std_logic;                                        -- ready
			sink_valid         : in  std_logic                     := 'X';             -- valid
			sink_data          : in  std_logic_vector(90 downto 0) := (others => 'X'); -- data
			sink_startofpacket : in  std_logic                     := 'X';             -- startofpacket
			sink_endofpacket   : in  std_logic                     := 'X';             -- endofpacket
			clk                : in  std_logic                     := 'X';             -- clk
			reset              : in  std_logic                     := 'X';             -- reset
			src_ready          : in  std_logic                     := 'X';             -- ready
			src_valid          : out std_logic;                                        -- valid
			src_data           : out std_logic_vector(90 downto 0);                    -- data
			src_channel        : out std_logic_vector(5 downto 0);                     -- channel
			src_startofpacket  : out std_logic;                                        -- startofpacket
			src_endofpacket    : out std_logic                                         -- endofpacket
		);
	end component integration_addr_router_001;

	component integration_id_router is
		port (
			sink_ready         : out std_logic;                                        -- ready
			sink_valid         : in  std_logic                     := 'X';             -- valid
			sink_data          : in  std_logic_vector(90 downto 0) := (others => 'X'); -- data
			sink_startofpacket : in  std_logic                     := 'X';             -- startofpacket
			sink_endofpacket   : in  std_logic                     := 'X';             -- endofpacket
			clk                : in  std_logic                     := 'X';             -- clk
			reset              : in  std_logic                     := 'X';             -- reset
			src_ready          : in  std_logic                     := 'X';             -- ready
			src_valid          : out std_logic;                                        -- valid
			src_data           : out std_logic_vector(90 downto 0);                    -- data
			src_channel        : out std_logic_vector(5 downto 0);                     -- channel
			src_startofpacket  : out std_logic;                                        -- startofpacket
			src_endofpacket    : out std_logic                                         -- endofpacket
		);
	end component integration_id_router;

	component integration_id_router_002 is
		port (
			sink_ready         : out std_logic;                                        -- ready
			sink_valid         : in  std_logic                     := 'X';             -- valid
			sink_data          : in  std_logic_vector(90 downto 0) := (others => 'X'); -- data
			sink_startofpacket : in  std_logic                     := 'X';             -- startofpacket
			sink_endofpacket   : in  std_logic                     := 'X';             -- endofpacket
			clk                : in  std_logic                     := 'X';             -- clk
			reset              : in  std_logic                     := 'X';             -- reset
			src_ready          : in  std_logic                     := 'X';             -- ready
			src_valid          : out std_logic;                                        -- valid
			src_data           : out std_logic_vector(90 downto 0);                    -- data
			src_channel        : out std_logic_vector(5 downto 0);                     -- channel
			src_startofpacket  : out std_logic;                                        -- startofpacket
			src_endofpacket    : out std_logic                                         -- endofpacket
		);
	end component integration_id_router_002;

	component integration_id_router_005 is
		port (
			sink_ready         : out std_logic;                                        -- ready
			sink_valid         : in  std_logic                     := 'X';             -- valid
			sink_data          : in  std_logic_vector(72 downto 0) := (others => 'X'); -- data
			sink_startofpacket : in  std_logic                     := 'X';             -- startofpacket
			sink_endofpacket   : in  std_logic                     := 'X';             -- endofpacket
			clk                : in  std_logic                     := 'X';             -- clk
			reset              : in  std_logic                     := 'X';             -- reset
			src_ready          : in  std_logic                     := 'X';             -- ready
			src_valid          : out std_logic;                                        -- valid
			src_data           : out std_logic_vector(72 downto 0);                    -- data
			src_channel        : out std_logic_vector(5 downto 0);                     -- channel
			src_startofpacket  : out std_logic;                                        -- startofpacket
			src_endofpacket    : out std_logic                                         -- endofpacket
		);
	end component integration_id_router_005;

	component altera_merlin_traffic_limiter is
		generic (
			PKT_DEST_ID_H             : integer := 0;
			PKT_DEST_ID_L             : integer := 0;
			PKT_TRANS_POSTED          : integer := 0;
			PKT_TRANS_WRITE           : integer := 0;
			MAX_OUTSTANDING_RESPONSES : integer := 0;
			PIPELINED                 : integer := 0;
			ST_DATA_W                 : integer := 72;
			ST_CHANNEL_W              : integer := 1;
			VALID_WIDTH               : integer := 1;
			ENFORCE_ORDER             : integer := 1;
			PREVENT_HAZARDS           : integer := 0;
			PKT_BYTE_CNT_H            : integer := 0;
			PKT_BYTE_CNT_L            : integer := 0;
			PKT_BYTEEN_H              : integer := 0;
			PKT_BYTEEN_L              : integer := 0
		);
		port (
			clk                    : in  std_logic                     := 'X';             -- clk
			reset                  : in  std_logic                     := 'X';             -- reset
			cmd_sink_ready         : out std_logic;                                        -- ready
			cmd_sink_valid         : in  std_logic                     := 'X';             -- valid
			cmd_sink_data          : in  std_logic_vector(90 downto 0) := (others => 'X'); -- data
			cmd_sink_channel       : in  std_logic_vector(5 downto 0)  := (others => 'X'); -- channel
			cmd_sink_startofpacket : in  std_logic                     := 'X';             -- startofpacket
			cmd_sink_endofpacket   : in  std_logic                     := 'X';             -- endofpacket
			cmd_src_ready          : in  std_logic                     := 'X';             -- ready
			cmd_src_data           : out std_logic_vector(90 downto 0);                    -- data
			cmd_src_channel        : out std_logic_vector(5 downto 0);                     -- channel
			cmd_src_startofpacket  : out std_logic;                                        -- startofpacket
			cmd_src_endofpacket    : out std_logic;                                        -- endofpacket
			rsp_sink_ready         : out std_logic;                                        -- ready
			rsp_sink_valid         : in  std_logic                     := 'X';             -- valid
			rsp_sink_channel       : in  std_logic_vector(5 downto 0)  := (others => 'X'); -- channel
			rsp_sink_data          : in  std_logic_vector(90 downto 0) := (others => 'X'); -- data
			rsp_sink_startofpacket : in  std_logic                     := 'X';             -- startofpacket
			rsp_sink_endofpacket   : in  std_logic                     := 'X';             -- endofpacket
			rsp_src_ready          : in  std_logic                     := 'X';             -- ready
			rsp_src_valid          : out std_logic;                                        -- valid
			rsp_src_data           : out std_logic_vector(90 downto 0);                    -- data
			rsp_src_channel        : out std_logic_vector(5 downto 0);                     -- channel
			rsp_src_startofpacket  : out std_logic;                                        -- startofpacket
			rsp_src_endofpacket    : out std_logic;                                        -- endofpacket
			cmd_src_valid          : out std_logic_vector(5 downto 0)                      -- data
		);
	end component altera_merlin_traffic_limiter;

	component altera_merlin_burst_adapter is
		generic (
			PKT_ADDR_H                : integer := 79;
			PKT_ADDR_L                : integer := 48;
			PKT_BEGIN_BURST           : integer := 81;
			PKT_BYTE_CNT_H            : integer := 5;
			PKT_BYTE_CNT_L            : integer := 0;
			PKT_BYTEEN_H              : integer := 83;
			PKT_BYTEEN_L              : integer := 80;
			PKT_BURST_SIZE_H          : integer := 86;
			PKT_BURST_SIZE_L          : integer := 84;
			PKT_BURST_TYPE_H          : integer := 88;
			PKT_BURST_TYPE_L          : integer := 87;
			PKT_BURSTWRAP_H           : integer := 11;
			PKT_BURSTWRAP_L           : integer := 6;
			PKT_TRANS_COMPRESSED_READ : integer := 14;
			PKT_TRANS_WRITE           : integer := 13;
			PKT_TRANS_READ            : integer := 12;
			OUT_NARROW_SIZE           : integer := 0;
			IN_NARROW_SIZE            : integer := 0;
			OUT_FIXED                 : integer := 0;
			OUT_COMPLETE_WRAP         : integer := 0;
			ST_DATA_W                 : integer := 89;
			ST_CHANNEL_W              : integer := 8;
			OUT_BYTE_CNT_H            : integer := 5;
			OUT_BURSTWRAP_H           : integer := 11;
			COMPRESSED_READ_SUPPORT   : integer := 1;
			BYTEENABLE_SYNTHESIS      : integer := 0;
			PIPE_INPUTS               : integer := 0;
			NO_WRAP_SUPPORT           : integer := 0;
			BURSTWRAP_CONST_MASK      : integer := 0;
			BURSTWRAP_CONST_VALUE     : integer := -1
		);
		port (
			clk                   : in  std_logic                     := 'X';             -- clk
			reset                 : in  std_logic                     := 'X';             -- reset
			sink0_valid           : in  std_logic                     := 'X';             -- valid
			sink0_data            : in  std_logic_vector(72 downto 0) := (others => 'X'); -- data
			sink0_channel         : in  std_logic_vector(5 downto 0)  := (others => 'X'); -- channel
			sink0_startofpacket   : in  std_logic                     := 'X';             -- startofpacket
			sink0_endofpacket     : in  std_logic                     := 'X';             -- endofpacket
			sink0_ready           : out std_logic;                                        -- ready
			source0_valid         : out std_logic;                                        -- valid
			source0_data          : out std_logic_vector(72 downto 0);                    -- data
			source0_channel       : out std_logic_vector(5 downto 0);                     -- channel
			source0_startofpacket : out std_logic;                                        -- startofpacket
			source0_endofpacket   : out std_logic;                                        -- endofpacket
			source0_ready         : in  std_logic                     := 'X'              -- ready
		);
	end component altera_merlin_burst_adapter;

	component integration_cmd_xbar_demux is
		port (
			clk                : in  std_logic                     := 'X';             -- clk
			reset              : in  std_logic                     := 'X';             -- reset
			sink_ready         : out std_logic;                                        -- ready
			sink_channel       : in  std_logic_vector(5 downto 0)  := (others => 'X'); -- channel
			sink_data          : in  std_logic_vector(90 downto 0) := (others => 'X'); -- data
			sink_startofpacket : in  std_logic                     := 'X';             -- startofpacket
			sink_endofpacket   : in  std_logic                     := 'X';             -- endofpacket
			sink_valid         : in  std_logic_vector(5 downto 0)  := (others => 'X'); -- data
			src0_ready         : in  std_logic                     := 'X';             -- ready
			src0_valid         : out std_logic;                                        -- valid
			src0_data          : out std_logic_vector(90 downto 0);                    -- data
			src0_channel       : out std_logic_vector(5 downto 0);                     -- channel
			src0_startofpacket : out std_logic;                                        -- startofpacket
			src0_endofpacket   : out std_logic;                                        -- endofpacket
			src1_ready         : in  std_logic                     := 'X';             -- ready
			src1_valid         : out std_logic;                                        -- valid
			src1_data          : out std_logic_vector(90 downto 0);                    -- data
			src1_channel       : out std_logic_vector(5 downto 0);                     -- channel
			src1_startofpacket : out std_logic;                                        -- startofpacket
			src1_endofpacket   : out std_logic                                         -- endofpacket
		);
	end component integration_cmd_xbar_demux;

	component integration_cmd_xbar_demux_001 is
		port (
			clk                : in  std_logic                     := 'X';             -- clk
			reset              : in  std_logic                     := 'X';             -- reset
			sink_ready         : out std_logic;                                        -- ready
			sink_channel       : in  std_logic_vector(5 downto 0)  := (others => 'X'); -- channel
			sink_data          : in  std_logic_vector(90 downto 0) := (others => 'X'); -- data
			sink_startofpacket : in  std_logic                     := 'X';             -- startofpacket
			sink_endofpacket   : in  std_logic                     := 'X';             -- endofpacket
			sink_valid         : in  std_logic_vector(0 downto 0)  := (others => 'X'); -- valid
			src0_ready         : in  std_logic                     := 'X';             -- ready
			src0_valid         : out std_logic;                                        -- valid
			src0_data          : out std_logic_vector(90 downto 0);                    -- data
			src0_channel       : out std_logic_vector(5 downto 0);                     -- channel
			src0_startofpacket : out std_logic;                                        -- startofpacket
			src0_endofpacket   : out std_logic;                                        -- endofpacket
			src1_ready         : in  std_logic                     := 'X';             -- ready
			src1_valid         : out std_logic;                                        -- valid
			src1_data          : out std_logic_vector(90 downto 0);                    -- data
			src1_channel       : out std_logic_vector(5 downto 0);                     -- channel
			src1_startofpacket : out std_logic;                                        -- startofpacket
			src1_endofpacket   : out std_logic;                                        -- endofpacket
			src2_ready         : in  std_logic                     := 'X';             -- ready
			src2_valid         : out std_logic;                                        -- valid
			src2_data          : out std_logic_vector(90 downto 0);                    -- data
			src2_channel       : out std_logic_vector(5 downto 0);                     -- channel
			src2_startofpacket : out std_logic;                                        -- startofpacket
			src2_endofpacket   : out std_logic;                                        -- endofpacket
			src3_ready         : in  std_logic                     := 'X';             -- ready
			src3_valid         : out std_logic;                                        -- valid
			src3_data          : out std_logic_vector(90 downto 0);                    -- data
			src3_channel       : out std_logic_vector(5 downto 0);                     -- channel
			src3_startofpacket : out std_logic;                                        -- startofpacket
			src3_endofpacket   : out std_logic;                                        -- endofpacket
			src4_ready         : in  std_logic                     := 'X';             -- ready
			src4_valid         : out std_logic;                                        -- valid
			src4_data          : out std_logic_vector(90 downto 0);                    -- data
			src4_channel       : out std_logic_vector(5 downto 0);                     -- channel
			src4_startofpacket : out std_logic;                                        -- startofpacket
			src4_endofpacket   : out std_logic;                                        -- endofpacket
			src5_ready         : in  std_logic                     := 'X';             -- ready
			src5_valid         : out std_logic;                                        -- valid
			src5_data          : out std_logic_vector(90 downto 0);                    -- data
			src5_channel       : out std_logic_vector(5 downto 0);                     -- channel
			src5_startofpacket : out std_logic;                                        -- startofpacket
			src5_endofpacket   : out std_logic                                         -- endofpacket
		);
	end component integration_cmd_xbar_demux_001;

	component integration_cmd_xbar_mux is
		port (
			clk                 : in  std_logic                     := 'X';             -- clk
			reset               : in  std_logic                     := 'X';             -- reset
			src_ready           : in  std_logic                     := 'X';             -- ready
			src_valid           : out std_logic;                                        -- valid
			src_data            : out std_logic_vector(90 downto 0);                    -- data
			src_channel         : out std_logic_vector(5 downto 0);                     -- channel
			src_startofpacket   : out std_logic;                                        -- startofpacket
			src_endofpacket     : out std_logic;                                        -- endofpacket
			sink0_ready         : out std_logic;                                        -- ready
			sink0_valid         : in  std_logic                     := 'X';             -- valid
			sink0_channel       : in  std_logic_vector(5 downto 0)  := (others => 'X'); -- channel
			sink0_data          : in  std_logic_vector(90 downto 0) := (others => 'X'); -- data
			sink0_startofpacket : in  std_logic                     := 'X';             -- startofpacket
			sink0_endofpacket   : in  std_logic                     := 'X';             -- endofpacket
			sink1_ready         : out std_logic;                                        -- ready
			sink1_valid         : in  std_logic                     := 'X';             -- valid
			sink1_channel       : in  std_logic_vector(5 downto 0)  := (others => 'X'); -- channel
			sink1_data          : in  std_logic_vector(90 downto 0) := (others => 'X'); -- data
			sink1_startofpacket : in  std_logic                     := 'X';             -- startofpacket
			sink1_endofpacket   : in  std_logic                     := 'X'              -- endofpacket
		);
	end component integration_cmd_xbar_mux;

	component integration_rsp_xbar_demux is
		port (
			clk                : in  std_logic                     := 'X';             -- clk
			reset              : in  std_logic                     := 'X';             -- reset
			sink_ready         : out std_logic;                                        -- ready
			sink_channel       : in  std_logic_vector(5 downto 0)  := (others => 'X'); -- channel
			sink_data          : in  std_logic_vector(90 downto 0) := (others => 'X'); -- data
			sink_startofpacket : in  std_logic                     := 'X';             -- startofpacket
			sink_endofpacket   : in  std_logic                     := 'X';             -- endofpacket
			sink_valid         : in  std_logic_vector(0 downto 0)  := (others => 'X'); -- valid
			src0_ready         : in  std_logic                     := 'X';             -- ready
			src0_valid         : out std_logic;                                        -- valid
			src0_data          : out std_logic_vector(90 downto 0);                    -- data
			src0_channel       : out std_logic_vector(5 downto 0);                     -- channel
			src0_startofpacket : out std_logic;                                        -- startofpacket
			src0_endofpacket   : out std_logic;                                        -- endofpacket
			src1_ready         : in  std_logic                     := 'X';             -- ready
			src1_valid         : out std_logic;                                        -- valid
			src1_data          : out std_logic_vector(90 downto 0);                    -- data
			src1_channel       : out std_logic_vector(5 downto 0);                     -- channel
			src1_startofpacket : out std_logic;                                        -- startofpacket
			src1_endofpacket   : out std_logic                                         -- endofpacket
		);
	end component integration_rsp_xbar_demux;

	component integration_rsp_xbar_demux_002 is
		port (
			clk                : in  std_logic                     := 'X';             -- clk
			reset              : in  std_logic                     := 'X';             -- reset
			sink_ready         : out std_logic;                                        -- ready
			sink_channel       : in  std_logic_vector(5 downto 0)  := (others => 'X'); -- channel
			sink_data          : in  std_logic_vector(90 downto 0) := (others => 'X'); -- data
			sink_startofpacket : in  std_logic                     := 'X';             -- startofpacket
			sink_endofpacket   : in  std_logic                     := 'X';             -- endofpacket
			sink_valid         : in  std_logic_vector(0 downto 0)  := (others => 'X'); -- valid
			src0_ready         : in  std_logic                     := 'X';             -- ready
			src0_valid         : out std_logic;                                        -- valid
			src0_data          : out std_logic_vector(90 downto 0);                    -- data
			src0_channel       : out std_logic_vector(5 downto 0);                     -- channel
			src0_startofpacket : out std_logic;                                        -- startofpacket
			src0_endofpacket   : out std_logic                                         -- endofpacket
		);
	end component integration_rsp_xbar_demux_002;

	component integration_rsp_xbar_mux is
		port (
			clk                 : in  std_logic                     := 'X';             -- clk
			reset               : in  std_logic                     := 'X';             -- reset
			src_ready           : in  std_logic                     := 'X';             -- ready
			src_valid           : out std_logic;                                        -- valid
			src_data            : out std_logic_vector(90 downto 0);                    -- data
			src_channel         : out std_logic_vector(5 downto 0);                     -- channel
			src_startofpacket   : out std_logic;                                        -- startofpacket
			src_endofpacket     : out std_logic;                                        -- endofpacket
			sink0_ready         : out std_logic;                                        -- ready
			sink0_valid         : in  std_logic                     := 'X';             -- valid
			sink0_channel       : in  std_logic_vector(5 downto 0)  := (others => 'X'); -- channel
			sink0_data          : in  std_logic_vector(90 downto 0) := (others => 'X'); -- data
			sink0_startofpacket : in  std_logic                     := 'X';             -- startofpacket
			sink0_endofpacket   : in  std_logic                     := 'X';             -- endofpacket
			sink1_ready         : out std_logic;                                        -- ready
			sink1_valid         : in  std_logic                     := 'X';             -- valid
			sink1_channel       : in  std_logic_vector(5 downto 0)  := (others => 'X'); -- channel
			sink1_data          : in  std_logic_vector(90 downto 0) := (others => 'X'); -- data
			sink1_startofpacket : in  std_logic                     := 'X';             -- startofpacket
			sink1_endofpacket   : in  std_logic                     := 'X'              -- endofpacket
		);
	end component integration_rsp_xbar_mux;

	component integration_rsp_xbar_mux_001 is
		port (
			clk                 : in  std_logic                     := 'X';             -- clk
			reset               : in  std_logic                     := 'X';             -- reset
			src_ready           : in  std_logic                     := 'X';             -- ready
			src_valid           : out std_logic;                                        -- valid
			src_data            : out std_logic_vector(90 downto 0);                    -- data
			src_channel         : out std_logic_vector(5 downto 0);                     -- channel
			src_startofpacket   : out std_logic;                                        -- startofpacket
			src_endofpacket     : out std_logic;                                        -- endofpacket
			sink0_ready         : out std_logic;                                        -- ready
			sink0_valid         : in  std_logic                     := 'X';             -- valid
			sink0_channel       : in  std_logic_vector(5 downto 0)  := (others => 'X'); -- channel
			sink0_data          : in  std_logic_vector(90 downto 0) := (others => 'X'); -- data
			sink0_startofpacket : in  std_logic                     := 'X';             -- startofpacket
			sink0_endofpacket   : in  std_logic                     := 'X';             -- endofpacket
			sink1_ready         : out std_logic;                                        -- ready
			sink1_valid         : in  std_logic                     := 'X';             -- valid
			sink1_channel       : in  std_logic_vector(5 downto 0)  := (others => 'X'); -- channel
			sink1_data          : in  std_logic_vector(90 downto 0) := (others => 'X'); -- data
			sink1_startofpacket : in  std_logic                     := 'X';             -- startofpacket
			sink1_endofpacket   : in  std_logic                     := 'X';             -- endofpacket
			sink2_ready         : out std_logic;                                        -- ready
			sink2_valid         : in  std_logic                     := 'X';             -- valid
			sink2_channel       : in  std_logic_vector(5 downto 0)  := (others => 'X'); -- channel
			sink2_data          : in  std_logic_vector(90 downto 0) := (others => 'X'); -- data
			sink2_startofpacket : in  std_logic                     := 'X';             -- startofpacket
			sink2_endofpacket   : in  std_logic                     := 'X';             -- endofpacket
			sink3_ready         : out std_logic;                                        -- ready
			sink3_valid         : in  std_logic                     := 'X';             -- valid
			sink3_channel       : in  std_logic_vector(5 downto 0)  := (others => 'X'); -- channel
			sink3_data          : in  std_logic_vector(90 downto 0) := (others => 'X'); -- data
			sink3_startofpacket : in  std_logic                     := 'X';             -- startofpacket
			sink3_endofpacket   : in  std_logic                     := 'X';             -- endofpacket
			sink4_ready         : out std_logic;                                        -- ready
			sink4_valid         : in  std_logic                     := 'X';             -- valid
			sink4_channel       : in  std_logic_vector(5 downto 0)  := (others => 'X'); -- channel
			sink4_data          : in  std_logic_vector(90 downto 0) := (others => 'X'); -- data
			sink4_startofpacket : in  std_logic                     := 'X';             -- startofpacket
			sink4_endofpacket   : in  std_logic                     := 'X';             -- endofpacket
			sink5_ready         : out std_logic;                                        -- ready
			sink5_valid         : in  std_logic                     := 'X';             -- valid
			sink5_channel       : in  std_logic_vector(5 downto 0)  := (others => 'X'); -- channel
			sink5_data          : in  std_logic_vector(90 downto 0) := (others => 'X'); -- data
			sink5_startofpacket : in  std_logic                     := 'X';             -- startofpacket
			sink5_endofpacket   : in  std_logic                     := 'X'              -- endofpacket
		);
	end component integration_rsp_xbar_mux_001;

	component integration_irq_mapper is
		port (
			clk           : in  std_logic                     := 'X'; -- clk
			reset         : in  std_logic                     := 'X'; -- reset
			receiver0_irq : in  std_logic                     := 'X'; -- irq
			sender_irq    : out std_logic_vector(31 downto 0)         -- irq
		);
	end component integration_irq_mapper;

	component integration_nios2_cpu_jtag_debug_module_translator_avalon_universal_slave_0_agent_rsp_fifo is
		generic (
			SYMBOLS_PER_BEAT    : integer := 1;
			BITS_PER_SYMBOL     : integer := 8;
			FIFO_DEPTH          : integer := 16;
			CHANNEL_WIDTH       : integer := 0;
			ERROR_WIDTH         : integer := 0;
			USE_PACKETS         : integer := 0;
			USE_FILL_LEVEL      : integer := 0;
			EMPTY_LATENCY       : integer := 3;
			USE_MEMORY_BLOCKS   : integer := 1;
			USE_STORE_FORWARD   : integer := 0;
			USE_ALMOST_FULL_IF  : integer := 0;
			USE_ALMOST_EMPTY_IF : integer := 0
		);
		port (
			clk               : in  std_logic                     := 'X';             -- clk
			reset             : in  std_logic                     := 'X';             -- reset
			in_data           : in  std_logic_vector(91 downto 0) := (others => 'X'); -- data
			in_valid          : in  std_logic                     := 'X';             -- valid
			in_ready          : out std_logic;                                        -- ready
			in_startofpacket  : in  std_logic                     := 'X';             -- startofpacket
			in_endofpacket    : in  std_logic                     := 'X';             -- endofpacket
			out_data          : out std_logic_vector(91 downto 0);                    -- data
			out_valid         : out std_logic;                                        -- valid
			out_ready         : in  std_logic                     := 'X';             -- ready
			out_startofpacket : out std_logic;                                        -- startofpacket
			out_endofpacket   : out std_logic;                                        -- endofpacket
			csr_address       : in  std_logic_vector(1 downto 0)  := (others => 'X'); -- address
			csr_read          : in  std_logic                     := 'X';             -- read
			csr_write         : in  std_logic                     := 'X';             -- write
			csr_readdata      : out std_logic_vector(31 downto 0);                    -- readdata
			csr_writedata     : in  std_logic_vector(31 downto 0) := (others => 'X'); -- writedata
			almost_full_data  : out std_logic;                                        -- data
			almost_empty_data : out std_logic;                                        -- data
			in_empty          : in  std_logic                     := 'X';             -- empty
			out_empty         : out std_logic;                                        -- empty
			in_error          : in  std_logic                     := 'X';             -- error
			out_error         : out std_logic;                                        -- error
			in_channel        : in  std_logic                     := 'X';             -- channel
			out_channel       : out std_logic                                         -- channel
		);
	end component integration_nios2_cpu_jtag_debug_module_translator_avalon_universal_slave_0_agent_rsp_fifo;

	component integration_s4pu_cpu_avalon_slave_translator_avalon_universal_slave_0_agent_rsp_fifo is
		generic (
			SYMBOLS_PER_BEAT    : integer := 1;
			BITS_PER_SYMBOL     : integer := 8;
			FIFO_DEPTH          : integer := 16;
			CHANNEL_WIDTH       : integer := 0;
			ERROR_WIDTH         : integer := 0;
			USE_PACKETS         : integer := 0;
			USE_FILL_LEVEL      : integer := 0;
			EMPTY_LATENCY       : integer := 3;
			USE_MEMORY_BLOCKS   : integer := 1;
			USE_STORE_FORWARD   : integer := 0;
			USE_ALMOST_FULL_IF  : integer := 0;
			USE_ALMOST_EMPTY_IF : integer := 0
		);
		port (
			clk               : in  std_logic                     := 'X';             -- clk
			reset             : in  std_logic                     := 'X';             -- reset
			in_data           : in  std_logic_vector(73 downto 0) := (others => 'X'); -- data
			in_valid          : in  std_logic                     := 'X';             -- valid
			in_ready          : out std_logic;                                        -- ready
			in_startofpacket  : in  std_logic                     := 'X';             -- startofpacket
			in_endofpacket    : in  std_logic                     := 'X';             -- endofpacket
			out_data          : out std_logic_vector(73 downto 0);                    -- data
			out_valid         : out std_logic;                                        -- valid
			out_ready         : in  std_logic                     := 'X';             -- ready
			out_startofpacket : out std_logic;                                        -- startofpacket
			out_endofpacket   : out std_logic;                                        -- endofpacket
			csr_address       : in  std_logic_vector(1 downto 0)  := (others => 'X'); -- address
			csr_read          : in  std_logic                     := 'X';             -- read
			csr_write         : in  std_logic                     := 'X';             -- write
			csr_readdata      : out std_logic_vector(31 downto 0);                    -- readdata
			csr_writedata     : in  std_logic_vector(31 downto 0) := (others => 'X'); -- writedata
			almost_full_data  : out std_logic;                                        -- data
			almost_empty_data : out std_logic;                                        -- data
			in_empty          : in  std_logic                     := 'X';             -- empty
			out_empty         : out std_logic;                                        -- empty
			in_error          : in  std_logic                     := 'X';             -- error
			out_error         : out std_logic;                                        -- error
			in_channel        : in  std_logic                     := 'X';             -- channel
			out_channel       : out std_logic                                         -- channel
		);
	end component integration_s4pu_cpu_avalon_slave_translator_avalon_universal_slave_0_agent_rsp_fifo;

	component integration_nios2_cpu_jtag_debug_module_translator_avalon_universal_slave_0_agent is
		generic (
			PKT_DATA_H                : integer := 31;
			PKT_DATA_L                : integer := 0;
			PKT_BEGIN_BURST           : integer := 81;
			PKT_SYMBOL_W              : integer := 8;
			PKT_BYTEEN_H              : integer := 71;
			PKT_BYTEEN_L              : integer := 68;
			PKT_ADDR_H                : integer := 63;
			PKT_ADDR_L                : integer := 32;
			PKT_TRANS_COMPRESSED_READ : integer := 67;
			PKT_TRANS_POSTED          : integer := 66;
			PKT_TRANS_WRITE           : integer := 65;
			PKT_TRANS_READ            : integer := 64;
			PKT_TRANS_LOCK            : integer := 87;
			PKT_SRC_ID_H              : integer := 74;
			PKT_SRC_ID_L              : integer := 72;
			PKT_DEST_ID_H             : integer := 77;
			PKT_DEST_ID_L             : integer := 75;
			PKT_BURSTWRAP_H           : integer := 85;
			PKT_BURSTWRAP_L           : integer := 82;
			PKT_BYTE_CNT_H            : integer := 81;
			PKT_BYTE_CNT_L            : integer := 78;
			PKT_PROTECTION_H          : integer := 86;
			PKT_PROTECTION_L          : integer := 86;
			PKT_RESPONSE_STATUS_H     : integer := 89;
			PKT_RESPONSE_STATUS_L     : integer := 88;
			PKT_BURST_SIZE_H          : integer := 92;
			PKT_BURST_SIZE_L          : integer := 90;
			ST_CHANNEL_W              : integer := 8;
			ST_DATA_W                 : integer := 93;
			AVS_BURSTCOUNT_W          : integer := 4;
			SUPPRESS_0_BYTEEN_CMD     : integer := 1;
			PREVENT_FIFO_OVERFLOW     : integer := 0;
			USE_READRESPONSE          : integer := 0;
			USE_WRITERESPONSE         : integer := 0
		);
		port (
			clk                     : in  std_logic                     := 'X';             -- clk
			reset                   : in  std_logic                     := 'X';             -- reset
			m0_address              : out std_logic_vector(17 downto 0);                    -- address
			m0_burstcount           : out std_logic_vector(2 downto 0);                     -- burstcount
			m0_byteenable           : out std_logic_vector(3 downto 0);                     -- byteenable
			m0_debugaccess          : out std_logic;                                        -- debugaccess
			m0_lock                 : out std_logic;                                        -- lock
			m0_readdata             : in  std_logic_vector(31 downto 0) := (others => 'X'); -- readdata
			m0_readdatavalid        : in  std_logic                     := 'X';             -- readdatavalid
			m0_read                 : out std_logic;                                        -- read
			m0_waitrequest          : in  std_logic                     := 'X';             -- waitrequest
			m0_writedata            : out std_logic_vector(31 downto 0);                    -- writedata
			m0_write                : out std_logic;                                        -- write
			rp_endofpacket          : out std_logic;                                        -- endofpacket
			rp_ready                : in  std_logic                     := 'X';             -- ready
			rp_valid                : out std_logic;                                        -- valid
			rp_data                 : out std_logic_vector(90 downto 0);                    -- data
			rp_startofpacket        : out std_logic;                                        -- startofpacket
			cp_ready                : out std_logic;                                        -- ready
			cp_valid                : in  std_logic                     := 'X';             -- valid
			cp_data                 : in  std_logic_vector(90 downto 0) := (others => 'X'); -- data
			cp_startofpacket        : in  std_logic                     := 'X';             -- startofpacket
			cp_endofpacket          : in  std_logic                     := 'X';             -- endofpacket
			cp_channel              : in  std_logic_vector(5 downto 0)  := (others => 'X'); -- channel
			rf_sink_ready           : out std_logic;                                        -- ready
			rf_sink_valid           : in  std_logic                     := 'X';             -- valid
			rf_sink_startofpacket   : in  std_logic                     := 'X';             -- startofpacket
			rf_sink_endofpacket     : in  std_logic                     := 'X';             -- endofpacket
			rf_sink_data            : in  std_logic_vector(91 downto 0) := (others => 'X'); -- data
			rf_source_ready         : in  std_logic                     := 'X';             -- ready
			rf_source_valid         : out std_logic;                                        -- valid
			rf_source_startofpacket : out std_logic;                                        -- startofpacket
			rf_source_endofpacket   : out std_logic;                                        -- endofpacket
			rf_source_data          : out std_logic_vector(91 downto 0);                    -- data
			rdata_fifo_sink_ready   : out std_logic;                                        -- ready
			rdata_fifo_sink_valid   : in  std_logic                     := 'X';             -- valid
			rdata_fifo_sink_data    : in  std_logic_vector(33 downto 0) := (others => 'X'); -- data
			rdata_fifo_src_ready    : in  std_logic                     := 'X';             -- ready
			rdata_fifo_src_valid    : out std_logic;                                        -- valid
			rdata_fifo_src_data     : out std_logic_vector(33 downto 0);                    -- data
			m0_response             : in  std_logic_vector(1 downto 0)  := (others => 'X'); -- response
			m0_writeresponserequest : out std_logic;                                        -- writeresponserequest
			m0_writeresponsevalid   : in  std_logic                     := 'X'              -- writeresponsevalid
		);
	end component integration_nios2_cpu_jtag_debug_module_translator_avalon_universal_slave_0_agent;

	component integration_s4pu_cpu_avalon_slave_translator_avalon_universal_slave_0_agent is
		generic (
			PKT_DATA_H                : integer := 31;
			PKT_DATA_L                : integer := 0;
			PKT_BEGIN_BURST           : integer := 81;
			PKT_SYMBOL_W              : integer := 8;
			PKT_BYTEEN_H              : integer := 71;
			PKT_BYTEEN_L              : integer := 68;
			PKT_ADDR_H                : integer := 63;
			PKT_ADDR_L                : integer := 32;
			PKT_TRANS_COMPRESSED_READ : integer := 67;
			PKT_TRANS_POSTED          : integer := 66;
			PKT_TRANS_WRITE           : integer := 65;
			PKT_TRANS_READ            : integer := 64;
			PKT_TRANS_LOCK            : integer := 87;
			PKT_SRC_ID_H              : integer := 74;
			PKT_SRC_ID_L              : integer := 72;
			PKT_DEST_ID_H             : integer := 77;
			PKT_DEST_ID_L             : integer := 75;
			PKT_BURSTWRAP_H           : integer := 85;
			PKT_BURSTWRAP_L           : integer := 82;
			PKT_BYTE_CNT_H            : integer := 81;
			PKT_BYTE_CNT_L            : integer := 78;
			PKT_PROTECTION_H          : integer := 86;
			PKT_PROTECTION_L          : integer := 86;
			PKT_RESPONSE_STATUS_H     : integer := 89;
			PKT_RESPONSE_STATUS_L     : integer := 88;
			PKT_BURST_SIZE_H          : integer := 92;
			PKT_BURST_SIZE_L          : integer := 90;
			ST_CHANNEL_W              : integer := 8;
			ST_DATA_W                 : integer := 93;
			AVS_BURSTCOUNT_W          : integer := 4;
			SUPPRESS_0_BYTEEN_CMD     : integer := 1;
			PREVENT_FIFO_OVERFLOW     : integer := 0;
			USE_READRESPONSE          : integer := 0;
			USE_WRITERESPONSE         : integer := 0
		);
		port (
			clk                     : in  std_logic                     := 'X';             -- clk
			reset                   : in  std_logic                     := 'X';             -- reset
			m0_address              : out std_logic_vector(17 downto 0);                    -- address
			m0_burstcount           : out std_logic_vector(1 downto 0);                     -- burstcount
			m0_byteenable           : out std_logic_vector(1 downto 0);                     -- byteenable
			m0_debugaccess          : out std_logic;                                        -- debugaccess
			m0_lock                 : out std_logic;                                        -- lock
			m0_readdata             : in  std_logic_vector(15 downto 0) := (others => 'X'); -- readdata
			m0_readdatavalid        : in  std_logic                     := 'X';             -- readdatavalid
			m0_read                 : out std_logic;                                        -- read
			m0_waitrequest          : in  std_logic                     := 'X';             -- waitrequest
			m0_writedata            : out std_logic_vector(15 downto 0);                    -- writedata
			m0_write                : out std_logic;                                        -- write
			rp_endofpacket          : out std_logic;                                        -- endofpacket
			rp_ready                : in  std_logic                     := 'X';             -- ready
			rp_valid                : out std_logic;                                        -- valid
			rp_data                 : out std_logic_vector(72 downto 0);                    -- data
			rp_startofpacket        : out std_logic;                                        -- startofpacket
			cp_ready                : out std_logic;                                        -- ready
			cp_valid                : in  std_logic                     := 'X';             -- valid
			cp_data                 : in  std_logic_vector(72 downto 0) := (others => 'X'); -- data
			cp_startofpacket        : in  std_logic                     := 'X';             -- startofpacket
			cp_endofpacket          : in  std_logic                     := 'X';             -- endofpacket
			cp_channel              : in  std_logic_vector(5 downto 0)  := (others => 'X'); -- channel
			rf_sink_ready           : out std_logic;                                        -- ready
			rf_sink_valid           : in  std_logic                     := 'X';             -- valid
			rf_sink_startofpacket   : in  std_logic                     := 'X';             -- startofpacket
			rf_sink_endofpacket     : in  std_logic                     := 'X';             -- endofpacket
			rf_sink_data            : in  std_logic_vector(73 downto 0) := (others => 'X'); -- data
			rf_source_ready         : in  std_logic                     := 'X';             -- ready
			rf_source_valid         : out std_logic;                                        -- valid
			rf_source_startofpacket : out std_logic;                                        -- startofpacket
			rf_source_endofpacket   : out std_logic;                                        -- endofpacket
			rf_source_data          : out std_logic_vector(73 downto 0);                    -- data
			rdata_fifo_sink_ready   : out std_logic;                                        -- ready
			rdata_fifo_sink_valid   : in  std_logic                     := 'X';             -- valid
			rdata_fifo_sink_data    : in  std_logic_vector(17 downto 0) := (others => 'X'); -- data
			rdata_fifo_src_ready    : in  std_logic                     := 'X';             -- ready
			rdata_fifo_src_valid    : out std_logic;                                        -- valid
			rdata_fifo_src_data     : out std_logic_vector(17 downto 0);                    -- data
			m0_response             : in  std_logic_vector(1 downto 0)  := (others => 'X'); -- response
			m0_writeresponserequest : out std_logic;                                        -- writeresponserequest
			m0_writeresponsevalid   : in  std_logic                     := 'X'              -- writeresponsevalid
		);
	end component integration_s4pu_cpu_avalon_slave_translator_avalon_universal_slave_0_agent;

	component integration_width_adapter is
		generic (
			IN_PKT_ADDR_H                 : integer := 60;
			IN_PKT_ADDR_L                 : integer := 36;
			IN_PKT_DATA_H                 : integer := 31;
			IN_PKT_DATA_L                 : integer := 0;
			IN_PKT_BYTEEN_H               : integer := 35;
			IN_PKT_BYTEEN_L               : integer := 32;
			IN_PKT_BYTE_CNT_H             : integer := 63;
			IN_PKT_BYTE_CNT_L             : integer := 61;
			IN_PKT_TRANS_COMPRESSED_READ  : integer := 65;
			IN_PKT_BURSTWRAP_H            : integer := 67;
			IN_PKT_BURSTWRAP_L            : integer := 66;
			IN_PKT_BURST_SIZE_H           : integer := 70;
			IN_PKT_BURST_SIZE_L           : integer := 68;
			IN_PKT_RESPONSE_STATUS_H      : integer := 72;
			IN_PKT_RESPONSE_STATUS_L      : integer := 71;
			IN_PKT_TRANS_EXCLUSIVE        : integer := 73;
			IN_PKT_BURST_TYPE_H           : integer := 75;
			IN_PKT_BURST_TYPE_L           : integer := 74;
			IN_ST_DATA_W                  : integer := 76;
			OUT_PKT_ADDR_H                : integer := 60;
			OUT_PKT_ADDR_L                : integer := 36;
			OUT_PKT_DATA_H                : integer := 31;
			OUT_PKT_DATA_L                : integer := 0;
			OUT_PKT_BYTEEN_H              : integer := 35;
			OUT_PKT_BYTEEN_L              : integer := 32;
			OUT_PKT_BYTE_CNT_H            : integer := 63;
			OUT_PKT_BYTE_CNT_L            : integer := 61;
			OUT_PKT_TRANS_COMPRESSED_READ : integer := 65;
			OUT_PKT_BURST_SIZE_H          : integer := 68;
			OUT_PKT_BURST_SIZE_L          : integer := 66;
			OUT_PKT_RESPONSE_STATUS_H     : integer := 70;
			OUT_PKT_RESPONSE_STATUS_L     : integer := 69;
			OUT_PKT_TRANS_EXCLUSIVE       : integer := 71;
			OUT_PKT_BURST_TYPE_H          : integer := 73;
			OUT_PKT_BURST_TYPE_L          : integer := 72;
			OUT_ST_DATA_W                 : integer := 74;
			ST_CHANNEL_W                  : integer := 32;
			OPTIMIZE_FOR_RSP              : integer := 0;
			RESPONSE_PATH                 : integer := 0
		);
		port (
			clk                  : in  std_logic                     := 'X';             -- clk
			reset                : in  std_logic                     := 'X';             -- reset
			in_valid             : in  std_logic                     := 'X';             -- valid
			in_channel           : in  std_logic_vector(5 downto 0)  := (others => 'X'); -- channel
			in_startofpacket     : in  std_logic                     := 'X';             -- startofpacket
			in_endofpacket       : in  std_logic                     := 'X';             -- endofpacket
			in_ready             : out std_logic;                                        -- ready
			in_data              : in  std_logic_vector(90 downto 0) := (others => 'X'); -- data
			out_endofpacket      : out std_logic;                                        -- endofpacket
			out_data             : out std_logic_vector(72 downto 0);                    -- data
			out_channel          : out std_logic_vector(5 downto 0);                     -- channel
			out_valid            : out std_logic;                                        -- valid
			out_ready            : in  std_logic                     := 'X';             -- ready
			out_startofpacket    : out std_logic;                                        -- startofpacket
			in_command_size_data : in  std_logic_vector(2 downto 0)  := (others => 'X')  -- data
		);
	end component integration_width_adapter;

	component integration_width_adapter_001 is
		generic (
			IN_PKT_ADDR_H                 : integer := 60;
			IN_PKT_ADDR_L                 : integer := 36;
			IN_PKT_DATA_H                 : integer := 31;
			IN_PKT_DATA_L                 : integer := 0;
			IN_PKT_BYTEEN_H               : integer := 35;
			IN_PKT_BYTEEN_L               : integer := 32;
			IN_PKT_BYTE_CNT_H             : integer := 63;
			IN_PKT_BYTE_CNT_L             : integer := 61;
			IN_PKT_TRANS_COMPRESSED_READ  : integer := 65;
			IN_PKT_BURSTWRAP_H            : integer := 67;
			IN_PKT_BURSTWRAP_L            : integer := 66;
			IN_PKT_BURST_SIZE_H           : integer := 70;
			IN_PKT_BURST_SIZE_L           : integer := 68;
			IN_PKT_RESPONSE_STATUS_H      : integer := 72;
			IN_PKT_RESPONSE_STATUS_L      : integer := 71;
			IN_PKT_TRANS_EXCLUSIVE        : integer := 73;
			IN_PKT_BURST_TYPE_H           : integer := 75;
			IN_PKT_BURST_TYPE_L           : integer := 74;
			IN_ST_DATA_W                  : integer := 76;
			OUT_PKT_ADDR_H                : integer := 60;
			OUT_PKT_ADDR_L                : integer := 36;
			OUT_PKT_DATA_H                : integer := 31;
			OUT_PKT_DATA_L                : integer := 0;
			OUT_PKT_BYTEEN_H              : integer := 35;
			OUT_PKT_BYTEEN_L              : integer := 32;
			OUT_PKT_BYTE_CNT_H            : integer := 63;
			OUT_PKT_BYTE_CNT_L            : integer := 61;
			OUT_PKT_TRANS_COMPRESSED_READ : integer := 65;
			OUT_PKT_BURST_SIZE_H          : integer := 68;
			OUT_PKT_BURST_SIZE_L          : integer := 66;
			OUT_PKT_RESPONSE_STATUS_H     : integer := 70;
			OUT_PKT_RESPONSE_STATUS_L     : integer := 69;
			OUT_PKT_TRANS_EXCLUSIVE       : integer := 71;
			OUT_PKT_BURST_TYPE_H          : integer := 73;
			OUT_PKT_BURST_TYPE_L          : integer := 72;
			OUT_ST_DATA_W                 : integer := 74;
			ST_CHANNEL_W                  : integer := 32;
			OPTIMIZE_FOR_RSP              : integer := 0;
			RESPONSE_PATH                 : integer := 0
		);
		port (
			clk                  : in  std_logic                     := 'X';             -- clk
			reset                : in  std_logic                     := 'X';             -- reset
			in_valid             : in  std_logic                     := 'X';             -- valid
			in_channel           : in  std_logic_vector(5 downto 0)  := (others => 'X'); -- channel
			in_startofpacket     : in  std_logic                     := 'X';             -- startofpacket
			in_endofpacket       : in  std_logic                     := 'X';             -- endofpacket
			in_ready             : out std_logic;                                        -- ready
			in_data              : in  std_logic_vector(72 downto 0) := (others => 'X'); -- data
			out_endofpacket      : out std_logic;                                        -- endofpacket
			out_data             : out std_logic_vector(90 downto 0);                    -- data
			out_channel          : out std_logic_vector(5 downto 0);                     -- channel
			out_valid            : out std_logic;                                        -- valid
			out_ready            : in  std_logic                     := 'X';             -- ready
			out_startofpacket    : out std_logic;                                        -- startofpacket
			in_command_size_data : in  std_logic_vector(2 downto 0)  := (others => 'X')  -- data
		);
	end component integration_width_adapter_001;

	component integration_nios2_cpu_instruction_master_translator is
		generic (
			AV_ADDRESS_W                : integer := 32;
			AV_DATA_W                   : integer := 32;
			AV_BURSTCOUNT_W             : integer := 4;
			AV_BYTEENABLE_W             : integer := 4;
			UAV_ADDRESS_W               : integer := 38;
			UAV_BURSTCOUNT_W            : integer := 10;
			USE_READ                    : integer := 1;
			USE_WRITE                   : integer := 1;
			USE_BEGINBURSTTRANSFER      : integer := 0;
			USE_BEGINTRANSFER           : integer := 0;
			USE_CHIPSELECT              : integer := 0;
			USE_BURSTCOUNT              : integer := 1;
			USE_READDATAVALID           : integer := 1;
			USE_WAITREQUEST             : integer := 1;
			USE_READRESPONSE            : integer := 0;
			USE_WRITERESPONSE           : integer := 0;
			AV_SYMBOLS_PER_WORD         : integer := 4;
			AV_ADDRESS_SYMBOLS          : integer := 0;
			AV_BURSTCOUNT_SYMBOLS       : integer := 0;
			AV_CONSTANT_BURST_BEHAVIOR  : integer := 0;
			UAV_CONSTANT_BURST_BEHAVIOR : integer := 0;
			AV_LINEWRAPBURSTS           : integer := 0;
			AV_REGISTERINCOMINGSIGNALS  : integer := 0
		);
		port (
			clk                      : in  std_logic                     := 'X';             -- clk
			reset                    : in  std_logic                     := 'X';             -- reset
			uav_address              : out std_logic_vector(17 downto 0);                    -- address
			uav_burstcount           : out std_logic_vector(2 downto 0);                     -- burstcount
			uav_read                 : out std_logic;                                        -- read
			uav_write                : out std_logic;                                        -- write
			uav_waitrequest          : in  std_logic                     := 'X';             -- waitrequest
			uav_readdatavalid        : in  std_logic                     := 'X';             -- readdatavalid
			uav_byteenable           : out std_logic_vector(3 downto 0);                     -- byteenable
			uav_readdata             : in  std_logic_vector(31 downto 0) := (others => 'X'); -- readdata
			uav_writedata            : out std_logic_vector(31 downto 0);                    -- writedata
			uav_lock                 : out std_logic;                                        -- lock
			uav_debugaccess          : out std_logic;                                        -- debugaccess
			av_address               : in  std_logic_vector(17 downto 0) := (others => 'X'); -- address
			av_waitrequest           : out std_logic;                                        -- waitrequest
			av_read                  : in  std_logic                     := 'X';             -- read
			av_readdata              : out std_logic_vector(31 downto 0);                    -- readdata
			av_readdatavalid         : out std_logic;                                        -- readdatavalid
			av_burstcount            : in  std_logic_vector(0 downto 0)  := (others => 'X'); -- burstcount
			av_byteenable            : in  std_logic_vector(3 downto 0)  := (others => 'X'); -- byteenable
			av_beginbursttransfer    : in  std_logic                     := 'X';             -- beginbursttransfer
			av_begintransfer         : in  std_logic                     := 'X';             -- begintransfer
			av_chipselect            : in  std_logic                     := 'X';             -- chipselect
			av_write                 : in  std_logic                     := 'X';             -- write
			av_writedata             : in  std_logic_vector(31 downto 0) := (others => 'X'); -- writedata
			av_lock                  : in  std_logic                     := 'X';             -- lock
			av_debugaccess           : in  std_logic                     := 'X';             -- debugaccess
			uav_clken                : out std_logic;                                        -- clken
			av_clken                 : in  std_logic                     := 'X';             -- clken
			uav_response             : in  std_logic_vector(1 downto 0)  := (others => 'X'); -- response
			av_response              : out std_logic_vector(1 downto 0);                     -- response
			uav_writeresponserequest : out std_logic;                                        -- writeresponserequest
			uav_writeresponsevalid   : in  std_logic                     := 'X';             -- writeresponsevalid
			av_writeresponserequest  : in  std_logic                     := 'X';             -- writeresponserequest
			av_writeresponsevalid    : out std_logic                                         -- writeresponsevalid
		);
	end component integration_nios2_cpu_instruction_master_translator;

	component integration_nios2_cpu_data_master_translator is
		generic (
			AV_ADDRESS_W                : integer := 32;
			AV_DATA_W                   : integer := 32;
			AV_BURSTCOUNT_W             : integer := 4;
			AV_BYTEENABLE_W             : integer := 4;
			UAV_ADDRESS_W               : integer := 38;
			UAV_BURSTCOUNT_W            : integer := 10;
			USE_READ                    : integer := 1;
			USE_WRITE                   : integer := 1;
			USE_BEGINBURSTTRANSFER      : integer := 0;
			USE_BEGINTRANSFER           : integer := 0;
			USE_CHIPSELECT              : integer := 0;
			USE_BURSTCOUNT              : integer := 1;
			USE_READDATAVALID           : integer := 1;
			USE_WAITREQUEST             : integer := 1;
			USE_READRESPONSE            : integer := 0;
			USE_WRITERESPONSE           : integer := 0;
			AV_SYMBOLS_PER_WORD         : integer := 4;
			AV_ADDRESS_SYMBOLS          : integer := 0;
			AV_BURSTCOUNT_SYMBOLS       : integer := 0;
			AV_CONSTANT_BURST_BEHAVIOR  : integer := 0;
			UAV_CONSTANT_BURST_BEHAVIOR : integer := 0;
			AV_LINEWRAPBURSTS           : integer := 0;
			AV_REGISTERINCOMINGSIGNALS  : integer := 0
		);
		port (
			clk                      : in  std_logic                     := 'X';             -- clk
			reset                    : in  std_logic                     := 'X';             -- reset
			uav_address              : out std_logic_vector(17 downto 0);                    -- address
			uav_burstcount           : out std_logic_vector(2 downto 0);                     -- burstcount
			uav_read                 : out std_logic;                                        -- read
			uav_write                : out std_logic;                                        -- write
			uav_waitrequest          : in  std_logic                     := 'X';             -- waitrequest
			uav_readdatavalid        : in  std_logic                     := 'X';             -- readdatavalid
			uav_byteenable           : out std_logic_vector(3 downto 0);                     -- byteenable
			uav_readdata             : in  std_logic_vector(31 downto 0) := (others => 'X'); -- readdata
			uav_writedata            : out std_logic_vector(31 downto 0);                    -- writedata
			uav_lock                 : out std_logic;                                        -- lock
			uav_debugaccess          : out std_logic;                                        -- debugaccess
			av_address               : in  std_logic_vector(17 downto 0) := (others => 'X'); -- address
			av_waitrequest           : out std_logic;                                        -- waitrequest
			av_byteenable            : in  std_logic_vector(3 downto 0)  := (others => 'X'); -- byteenable
			av_read                  : in  std_logic                     := 'X';             -- read
			av_readdata              : out std_logic_vector(31 downto 0);                    -- readdata
			av_write                 : in  std_logic                     := 'X';             -- write
			av_writedata             : in  std_logic_vector(31 downto 0) := (others => 'X'); -- writedata
			av_debugaccess           : in  std_logic                     := 'X';             -- debugaccess
			av_burstcount            : in  std_logic_vector(0 downto 0)  := (others => 'X'); -- burstcount
			av_beginbursttransfer    : in  std_logic                     := 'X';             -- beginbursttransfer
			av_begintransfer         : in  std_logic                     := 'X';             -- begintransfer
			av_chipselect            : in  std_logic                     := 'X';             -- chipselect
			av_readdatavalid         : out std_logic;                                        -- readdatavalid
			av_lock                  : in  std_logic                     := 'X';             -- lock
			uav_clken                : out std_logic;                                        -- clken
			av_clken                 : in  std_logic                     := 'X';             -- clken
			uav_response             : in  std_logic_vector(1 downto 0)  := (others => 'X'); -- response
			av_response              : out std_logic_vector(1 downto 0);                     -- response
			uav_writeresponserequest : out std_logic;                                        -- writeresponserequest
			uav_writeresponsevalid   : in  std_logic                     := 'X';             -- writeresponsevalid
			av_writeresponserequest  : in  std_logic                     := 'X';             -- writeresponserequest
			av_writeresponsevalid    : out std_logic                                         -- writeresponsevalid
		);
	end component integration_nios2_cpu_data_master_translator;

	component integration_nios2_cpu_jtag_debug_module_translator is
		generic (
			AV_ADDRESS_W                   : integer := 30;
			AV_DATA_W                      : integer := 32;
			UAV_DATA_W                     : integer := 32;
			AV_BURSTCOUNT_W                : integer := 4;
			AV_BYTEENABLE_W                : integer := 4;
			UAV_BYTEENABLE_W               : integer := 4;
			UAV_ADDRESS_W                  : integer := 32;
			UAV_BURSTCOUNT_W               : integer := 4;
			AV_READLATENCY                 : integer := 0;
			USE_READDATAVALID              : integer := 1;
			USE_WAITREQUEST                : integer := 1;
			USE_UAV_CLKEN                  : integer := 0;
			USE_READRESPONSE               : integer := 0;
			USE_WRITERESPONSE              : integer := 0;
			AV_SYMBOLS_PER_WORD            : integer := 4;
			AV_ADDRESS_SYMBOLS             : integer := 0;
			AV_BURSTCOUNT_SYMBOLS          : integer := 0;
			AV_CONSTANT_BURST_BEHAVIOR     : integer := 0;
			UAV_CONSTANT_BURST_BEHAVIOR    : integer := 0;
			AV_REQUIRE_UNALIGNED_ADDRESSES : integer := 0;
			CHIPSELECT_THROUGH_READLATENCY : integer := 0;
			AV_READ_WAIT_CYCLES            : integer := 0;
			AV_WRITE_WAIT_CYCLES           : integer := 0;
			AV_SETUP_WAIT_CYCLES           : integer := 0;
			AV_DATA_HOLD_CYCLES            : integer := 0
		);
		port (
			clk                      : in  std_logic                     := 'X';             -- clk
			reset                    : in  std_logic                     := 'X';             -- reset
			uav_address              : in  std_logic_vector(17 downto 0) := (others => 'X'); -- address
			uav_burstcount           : in  std_logic_vector(2 downto 0)  := (others => 'X'); -- burstcount
			uav_read                 : in  std_logic                     := 'X';             -- read
			uav_write                : in  std_logic                     := 'X';             -- write
			uav_waitrequest          : out std_logic;                                        -- waitrequest
			uav_readdatavalid        : out std_logic;                                        -- readdatavalid
			uav_byteenable           : in  std_logic_vector(3 downto 0)  := (others => 'X'); -- byteenable
			uav_readdata             : out std_logic_vector(31 downto 0);                    -- readdata
			uav_writedata            : in  std_logic_vector(31 downto 0) := (others => 'X'); -- writedata
			uav_lock                 : in  std_logic                     := 'X';             -- lock
			uav_debugaccess          : in  std_logic                     := 'X';             -- debugaccess
			av_address               : out std_logic_vector(8 downto 0);                     -- address
			av_write                 : out std_logic;                                        -- write
			av_read                  : out std_logic;                                        -- read
			av_readdata              : in  std_logic_vector(31 downto 0) := (others => 'X'); -- readdata
			av_writedata             : out std_logic_vector(31 downto 0);                    -- writedata
			av_byteenable            : out std_logic_vector(3 downto 0);                     -- byteenable
			av_waitrequest           : in  std_logic                     := 'X';             -- waitrequest
			av_debugaccess           : out std_logic;                                        -- debugaccess
			av_begintransfer         : out std_logic;                                        -- begintransfer
			av_beginbursttransfer    : out std_logic;                                        -- beginbursttransfer
			av_burstcount            : out std_logic_vector(0 downto 0);                     -- burstcount
			av_readdatavalid         : in  std_logic                     := 'X';             -- readdatavalid
			av_writebyteenable       : out std_logic_vector(3 downto 0);                     -- writebyteenable
			av_lock                  : out std_logic;                                        -- lock
			av_chipselect            : out std_logic;                                        -- chipselect
			av_clken                 : out std_logic;                                        -- clken
			uav_clken                : in  std_logic                     := 'X';             -- clken
			av_outputenable          : out std_logic;                                        -- outputenable
			uav_response             : out std_logic_vector(1 downto 0);                     -- response
			av_response              : in  std_logic_vector(1 downto 0)  := (others => 'X'); -- response
			uav_writeresponserequest : in  std_logic                     := 'X';             -- writeresponserequest
			uav_writeresponsevalid   : out std_logic;                                        -- writeresponsevalid
			av_writeresponserequest  : out std_logic;                                        -- writeresponserequest
			av_writeresponsevalid    : in  std_logic                     := 'X'              -- writeresponsevalid
		);
	end component integration_nios2_cpu_jtag_debug_module_translator;

	component integration_onchip_mem_nios2_s1_translator is
		generic (
			AV_ADDRESS_W                   : integer := 30;
			AV_DATA_W                      : integer := 32;
			UAV_DATA_W                     : integer := 32;
			AV_BURSTCOUNT_W                : integer := 4;
			AV_BYTEENABLE_W                : integer := 4;
			UAV_BYTEENABLE_W               : integer := 4;
			UAV_ADDRESS_W                  : integer := 32;
			UAV_BURSTCOUNT_W               : integer := 4;
			AV_READLATENCY                 : integer := 0;
			USE_READDATAVALID              : integer := 1;
			USE_WAITREQUEST                : integer := 1;
			USE_UAV_CLKEN                  : integer := 0;
			USE_READRESPONSE               : integer := 0;
			USE_WRITERESPONSE              : integer := 0;
			AV_SYMBOLS_PER_WORD            : integer := 4;
			AV_ADDRESS_SYMBOLS             : integer := 0;
			AV_BURSTCOUNT_SYMBOLS          : integer := 0;
			AV_CONSTANT_BURST_BEHAVIOR     : integer := 0;
			UAV_CONSTANT_BURST_BEHAVIOR    : integer := 0;
			AV_REQUIRE_UNALIGNED_ADDRESSES : integer := 0;
			CHIPSELECT_THROUGH_READLATENCY : integer := 0;
			AV_READ_WAIT_CYCLES            : integer := 0;
			AV_WRITE_WAIT_CYCLES           : integer := 0;
			AV_SETUP_WAIT_CYCLES           : integer := 0;
			AV_DATA_HOLD_CYCLES            : integer := 0
		);
		port (
			clk                      : in  std_logic                     := 'X';             -- clk
			reset                    : in  std_logic                     := 'X';             -- reset
			uav_address              : in  std_logic_vector(17 downto 0) := (others => 'X'); -- address
			uav_burstcount           : in  std_logic_vector(2 downto 0)  := (others => 'X'); -- burstcount
			uav_read                 : in  std_logic                     := 'X';             -- read
			uav_write                : in  std_logic                     := 'X';             -- write
			uav_waitrequest          : out std_logic;                                        -- waitrequest
			uav_readdatavalid        : out std_logic;                                        -- readdatavalid
			uav_byteenable           : in  std_logic_vector(3 downto 0)  := (others => 'X'); -- byteenable
			uav_readdata             : out std_logic_vector(31 downto 0);                    -- readdata
			uav_writedata            : in  std_logic_vector(31 downto 0) := (others => 'X'); -- writedata
			uav_lock                 : in  std_logic                     := 'X';             -- lock
			uav_debugaccess          : in  std_logic                     := 'X';             -- debugaccess
			av_address               : out std_logic_vector(11 downto 0);                    -- address
			av_write                 : out std_logic;                                        -- write
			av_readdata              : in  std_logic_vector(31 downto 0) := (others => 'X'); -- readdata
			av_writedata             : out std_logic_vector(31 downto 0);                    -- writedata
			av_byteenable            : out std_logic_vector(3 downto 0);                     -- byteenable
			av_chipselect            : out std_logic;                                        -- chipselect
			av_clken                 : out std_logic;                                        -- clken
			av_read                  : out std_logic;                                        -- read
			av_begintransfer         : out std_logic;                                        -- begintransfer
			av_beginbursttransfer    : out std_logic;                                        -- beginbursttransfer
			av_burstcount            : out std_logic_vector(0 downto 0);                     -- burstcount
			av_readdatavalid         : in  std_logic                     := 'X';             -- readdatavalid
			av_waitrequest           : in  std_logic                     := 'X';             -- waitrequest
			av_writebyteenable       : out std_logic_vector(3 downto 0);                     -- writebyteenable
			av_lock                  : out std_logic;                                        -- lock
			uav_clken                : in  std_logic                     := 'X';             -- clken
			av_debugaccess           : out std_logic;                                        -- debugaccess
			av_outputenable          : out std_logic;                                        -- outputenable
			uav_response             : out std_logic_vector(1 downto 0);                     -- response
			av_response              : in  std_logic_vector(1 downto 0)  := (others => 'X'); -- response
			uav_writeresponserequest : in  std_logic                     := 'X';             -- writeresponserequest
			uav_writeresponsevalid   : out std_logic;                                        -- writeresponsevalid
			av_writeresponserequest  : out std_logic;                                        -- writeresponserequest
			av_writeresponsevalid    : in  std_logic                     := 'X'              -- writeresponsevalid
		);
	end component integration_onchip_mem_nios2_s1_translator;

	component integration_jtag_uart_avalon_jtag_slave_translator is
		generic (
			AV_ADDRESS_W                   : integer := 30;
			AV_DATA_W                      : integer := 32;
			UAV_DATA_W                     : integer := 32;
			AV_BURSTCOUNT_W                : integer := 4;
			AV_BYTEENABLE_W                : integer := 4;
			UAV_BYTEENABLE_W               : integer := 4;
			UAV_ADDRESS_W                  : integer := 32;
			UAV_BURSTCOUNT_W               : integer := 4;
			AV_READLATENCY                 : integer := 0;
			USE_READDATAVALID              : integer := 1;
			USE_WAITREQUEST                : integer := 1;
			USE_UAV_CLKEN                  : integer := 0;
			USE_READRESPONSE               : integer := 0;
			USE_WRITERESPONSE              : integer := 0;
			AV_SYMBOLS_PER_WORD            : integer := 4;
			AV_ADDRESS_SYMBOLS             : integer := 0;
			AV_BURSTCOUNT_SYMBOLS          : integer := 0;
			AV_CONSTANT_BURST_BEHAVIOR     : integer := 0;
			UAV_CONSTANT_BURST_BEHAVIOR    : integer := 0;
			AV_REQUIRE_UNALIGNED_ADDRESSES : integer := 0;
			CHIPSELECT_THROUGH_READLATENCY : integer := 0;
			AV_READ_WAIT_CYCLES            : integer := 0;
			AV_WRITE_WAIT_CYCLES           : integer := 0;
			AV_SETUP_WAIT_CYCLES           : integer := 0;
			AV_DATA_HOLD_CYCLES            : integer := 0
		);
		port (
			clk                      : in  std_logic                     := 'X';             -- clk
			reset                    : in  std_logic                     := 'X';             -- reset
			uav_address              : in  std_logic_vector(17 downto 0) := (others => 'X'); -- address
			uav_burstcount           : in  std_logic_vector(2 downto 0)  := (others => 'X'); -- burstcount
			uav_read                 : in  std_logic                     := 'X';             -- read
			uav_write                : in  std_logic                     := 'X';             -- write
			uav_waitrequest          : out std_logic;                                        -- waitrequest
			uav_readdatavalid        : out std_logic;                                        -- readdatavalid
			uav_byteenable           : in  std_logic_vector(3 downto 0)  := (others => 'X'); -- byteenable
			uav_readdata             : out std_logic_vector(31 downto 0);                    -- readdata
			uav_writedata            : in  std_logic_vector(31 downto 0) := (others => 'X'); -- writedata
			uav_lock                 : in  std_logic                     := 'X';             -- lock
			uav_debugaccess          : in  std_logic                     := 'X';             -- debugaccess
			av_address               : out std_logic_vector(0 downto 0);                     -- address
			av_write                 : out std_logic;                                        -- write
			av_read                  : out std_logic;                                        -- read
			av_readdata              : in  std_logic_vector(31 downto 0) := (others => 'X'); -- readdata
			av_writedata             : out std_logic_vector(31 downto 0);                    -- writedata
			av_waitrequest           : in  std_logic                     := 'X';             -- waitrequest
			av_chipselect            : out std_logic;                                        -- chipselect
			av_begintransfer         : out std_logic;                                        -- begintransfer
			av_beginbursttransfer    : out std_logic;                                        -- beginbursttransfer
			av_burstcount            : out std_logic_vector(0 downto 0);                     -- burstcount
			av_byteenable            : out std_logic_vector(0 downto 0);                     -- byteenable
			av_readdatavalid         : in  std_logic                     := 'X';             -- readdatavalid
			av_writebyteenable       : out std_logic_vector(0 downto 0);                     -- writebyteenable
			av_lock                  : out std_logic;                                        -- lock
			av_clken                 : out std_logic;                                        -- clken
			uav_clken                : in  std_logic                     := 'X';             -- clken
			av_debugaccess           : out std_logic;                                        -- debugaccess
			av_outputenable          : out std_logic;                                        -- outputenable
			uav_response             : out std_logic_vector(1 downto 0);                     -- response
			av_response              : in  std_logic_vector(1 downto 0)  := (others => 'X'); -- response
			uav_writeresponserequest : in  std_logic                     := 'X';             -- writeresponserequest
			uav_writeresponsevalid   : out std_logic;                                        -- writeresponsevalid
			av_writeresponserequest  : out std_logic;                                        -- writeresponserequest
			av_writeresponsevalid    : in  std_logic                     := 'X'              -- writeresponsevalid
		);
	end component integration_jtag_uart_avalon_jtag_slave_translator;

	component integration_sysid_control_slave_translator is
		generic (
			AV_ADDRESS_W                   : integer := 30;
			AV_DATA_W                      : integer := 32;
			UAV_DATA_W                     : integer := 32;
			AV_BURSTCOUNT_W                : integer := 4;
			AV_BYTEENABLE_W                : integer := 4;
			UAV_BYTEENABLE_W               : integer := 4;
			UAV_ADDRESS_W                  : integer := 32;
			UAV_BURSTCOUNT_W               : integer := 4;
			AV_READLATENCY                 : integer := 0;
			USE_READDATAVALID              : integer := 1;
			USE_WAITREQUEST                : integer := 1;
			USE_UAV_CLKEN                  : integer := 0;
			USE_READRESPONSE               : integer := 0;
			USE_WRITERESPONSE              : integer := 0;
			AV_SYMBOLS_PER_WORD            : integer := 4;
			AV_ADDRESS_SYMBOLS             : integer := 0;
			AV_BURSTCOUNT_SYMBOLS          : integer := 0;
			AV_CONSTANT_BURST_BEHAVIOR     : integer := 0;
			UAV_CONSTANT_BURST_BEHAVIOR    : integer := 0;
			AV_REQUIRE_UNALIGNED_ADDRESSES : integer := 0;
			CHIPSELECT_THROUGH_READLATENCY : integer := 0;
			AV_READ_WAIT_CYCLES            : integer := 0;
			AV_WRITE_WAIT_CYCLES           : integer := 0;
			AV_SETUP_WAIT_CYCLES           : integer := 0;
			AV_DATA_HOLD_CYCLES            : integer := 0
		);
		port (
			clk                      : in  std_logic                     := 'X';             -- clk
			reset                    : in  std_logic                     := 'X';             -- reset
			uav_address              : in  std_logic_vector(17 downto 0) := (others => 'X'); -- address
			uav_burstcount           : in  std_logic_vector(2 downto 0)  := (others => 'X'); -- burstcount
			uav_read                 : in  std_logic                     := 'X';             -- read
			uav_write                : in  std_logic                     := 'X';             -- write
			uav_waitrequest          : out std_logic;                                        -- waitrequest
			uav_readdatavalid        : out std_logic;                                        -- readdatavalid
			uav_byteenable           : in  std_logic_vector(3 downto 0)  := (others => 'X'); -- byteenable
			uav_readdata             : out std_logic_vector(31 downto 0);                    -- readdata
			uav_writedata            : in  std_logic_vector(31 downto 0) := (others => 'X'); -- writedata
			uav_lock                 : in  std_logic                     := 'X';             -- lock
			uav_debugaccess          : in  std_logic                     := 'X';             -- debugaccess
			av_address               : out std_logic_vector(0 downto 0);                     -- address
			av_readdata              : in  std_logic_vector(31 downto 0) := (others => 'X'); -- readdata
			av_write                 : out std_logic;                                        -- write
			av_read                  : out std_logic;                                        -- read
			av_writedata             : out std_logic_vector(31 downto 0);                    -- writedata
			av_begintransfer         : out std_logic;                                        -- begintransfer
			av_beginbursttransfer    : out std_logic;                                        -- beginbursttransfer
			av_burstcount            : out std_logic_vector(0 downto 0);                     -- burstcount
			av_byteenable            : out std_logic_vector(3 downto 0);                     -- byteenable
			av_readdatavalid         : in  std_logic                     := 'X';             -- readdatavalid
			av_waitrequest           : in  std_logic                     := 'X';             -- waitrequest
			av_writebyteenable       : out std_logic_vector(3 downto 0);                     -- writebyteenable
			av_lock                  : out std_logic;                                        -- lock
			av_chipselect            : out std_logic;                                        -- chipselect
			av_clken                 : out std_logic;                                        -- clken
			uav_clken                : in  std_logic                     := 'X';             -- clken
			av_debugaccess           : out std_logic;                                        -- debugaccess
			av_outputenable          : out std_logic;                                        -- outputenable
			uav_response             : out std_logic_vector(1 downto 0);                     -- response
			av_response              : in  std_logic_vector(1 downto 0)  := (others => 'X'); -- response
			uav_writeresponserequest : in  std_logic                     := 'X';             -- writeresponserequest
			uav_writeresponsevalid   : out std_logic;                                        -- writeresponsevalid
			av_writeresponserequest  : out std_logic;                                        -- writeresponserequest
			av_writeresponsevalid    : in  std_logic                     := 'X'              -- writeresponsevalid
		);
	end component integration_sysid_control_slave_translator;

	component integration_pio_led_s1_translator is
		generic (
			AV_ADDRESS_W                   : integer := 30;
			AV_DATA_W                      : integer := 32;
			UAV_DATA_W                     : integer := 32;
			AV_BURSTCOUNT_W                : integer := 4;
			AV_BYTEENABLE_W                : integer := 4;
			UAV_BYTEENABLE_W               : integer := 4;
			UAV_ADDRESS_W                  : integer := 32;
			UAV_BURSTCOUNT_W               : integer := 4;
			AV_READLATENCY                 : integer := 0;
			USE_READDATAVALID              : integer := 1;
			USE_WAITREQUEST                : integer := 1;
			USE_UAV_CLKEN                  : integer := 0;
			USE_READRESPONSE               : integer := 0;
			USE_WRITERESPONSE              : integer := 0;
			AV_SYMBOLS_PER_WORD            : integer := 4;
			AV_ADDRESS_SYMBOLS             : integer := 0;
			AV_BURSTCOUNT_SYMBOLS          : integer := 0;
			AV_CONSTANT_BURST_BEHAVIOR     : integer := 0;
			UAV_CONSTANT_BURST_BEHAVIOR    : integer := 0;
			AV_REQUIRE_UNALIGNED_ADDRESSES : integer := 0;
			CHIPSELECT_THROUGH_READLATENCY : integer := 0;
			AV_READ_WAIT_CYCLES            : integer := 0;
			AV_WRITE_WAIT_CYCLES           : integer := 0;
			AV_SETUP_WAIT_CYCLES           : integer := 0;
			AV_DATA_HOLD_CYCLES            : integer := 0
		);
		port (
			clk                      : in  std_logic                     := 'X';             -- clk
			reset                    : in  std_logic                     := 'X';             -- reset
			uav_address              : in  std_logic_vector(17 downto 0) := (others => 'X'); -- address
			uav_burstcount           : in  std_logic_vector(2 downto 0)  := (others => 'X'); -- burstcount
			uav_read                 : in  std_logic                     := 'X';             -- read
			uav_write                : in  std_logic                     := 'X';             -- write
			uav_waitrequest          : out std_logic;                                        -- waitrequest
			uav_readdatavalid        : out std_logic;                                        -- readdatavalid
			uav_byteenable           : in  std_logic_vector(3 downto 0)  := (others => 'X'); -- byteenable
			uav_readdata             : out std_logic_vector(31 downto 0);                    -- readdata
			uav_writedata            : in  std_logic_vector(31 downto 0) := (others => 'X'); -- writedata
			uav_lock                 : in  std_logic                     := 'X';             -- lock
			uav_debugaccess          : in  std_logic                     := 'X';             -- debugaccess
			av_address               : out std_logic_vector(1 downto 0);                     -- address
			av_write                 : out std_logic;                                        -- write
			av_readdata              : in  std_logic_vector(31 downto 0) := (others => 'X'); -- readdata
			av_writedata             : out std_logic_vector(31 downto 0);                    -- writedata
			av_chipselect            : out std_logic;                                        -- chipselect
			av_read                  : out std_logic;                                        -- read
			av_begintransfer         : out std_logic;                                        -- begintransfer
			av_beginbursttransfer    : out std_logic;                                        -- beginbursttransfer
			av_burstcount            : out std_logic_vector(0 downto 0);                     -- burstcount
			av_byteenable            : out std_logic_vector(0 downto 0);                     -- byteenable
			av_readdatavalid         : in  std_logic                     := 'X';             -- readdatavalid
			av_waitrequest           : in  std_logic                     := 'X';             -- waitrequest
			av_writebyteenable       : out std_logic_vector(0 downto 0);                     -- writebyteenable
			av_lock                  : out std_logic;                                        -- lock
			av_clken                 : out std_logic;                                        -- clken
			uav_clken                : in  std_logic                     := 'X';             -- clken
			av_debugaccess           : out std_logic;                                        -- debugaccess
			av_outputenable          : out std_logic;                                        -- outputenable
			uav_response             : out std_logic_vector(1 downto 0);                     -- response
			av_response              : in  std_logic_vector(1 downto 0)  := (others => 'X'); -- response
			uav_writeresponserequest : in  std_logic                     := 'X';             -- writeresponserequest
			uav_writeresponsevalid   : out std_logic;                                        -- writeresponsevalid
			av_writeresponserequest  : out std_logic;                                        -- writeresponserequest
			av_writeresponsevalid    : in  std_logic                     := 'X'              -- writeresponsevalid
		);
	end component integration_pio_led_s1_translator;

	component integration_s4pu_cpu_avalon_slave_translator is
		generic (
			AV_ADDRESS_W                   : integer := 30;
			AV_DATA_W                      : integer := 32;
			UAV_DATA_W                     : integer := 32;
			AV_BURSTCOUNT_W                : integer := 4;
			AV_BYTEENABLE_W                : integer := 4;
			UAV_BYTEENABLE_W               : integer := 4;
			UAV_ADDRESS_W                  : integer := 32;
			UAV_BURSTCOUNT_W               : integer := 4;
			AV_READLATENCY                 : integer := 0;
			USE_READDATAVALID              : integer := 1;
			USE_WAITREQUEST                : integer := 1;
			USE_UAV_CLKEN                  : integer := 0;
			USE_READRESPONSE               : integer := 0;
			USE_WRITERESPONSE              : integer := 0;
			AV_SYMBOLS_PER_WORD            : integer := 4;
			AV_ADDRESS_SYMBOLS             : integer := 0;
			AV_BURSTCOUNT_SYMBOLS          : integer := 0;
			AV_CONSTANT_BURST_BEHAVIOR     : integer := 0;
			UAV_CONSTANT_BURST_BEHAVIOR    : integer := 0;
			AV_REQUIRE_UNALIGNED_ADDRESSES : integer := 0;
			CHIPSELECT_THROUGH_READLATENCY : integer := 0;
			AV_READ_WAIT_CYCLES            : integer := 0;
			AV_WRITE_WAIT_CYCLES           : integer := 0;
			AV_SETUP_WAIT_CYCLES           : integer := 0;
			AV_DATA_HOLD_CYCLES            : integer := 0
		);
		port (
			clk                      : in  std_logic                     := 'X';             -- clk
			reset                    : in  std_logic                     := 'X';             -- reset
			uav_address              : in  std_logic_vector(17 downto 0) := (others => 'X'); -- address
			uav_burstcount           : in  std_logic_vector(1 downto 0)  := (others => 'X'); -- burstcount
			uav_read                 : in  std_logic                     := 'X';             -- read
			uav_write                : in  std_logic                     := 'X';             -- write
			uav_waitrequest          : out std_logic;                                        -- waitrequest
			uav_readdatavalid        : out std_logic;                                        -- readdatavalid
			uav_byteenable           : in  std_logic_vector(1 downto 0)  := (others => 'X'); -- byteenable
			uav_readdata             : out std_logic_vector(15 downto 0);                    -- readdata
			uav_writedata            : in  std_logic_vector(15 downto 0) := (others => 'X'); -- writedata
			uav_lock                 : in  std_logic                     := 'X';             -- lock
			uav_debugaccess          : in  std_logic                     := 'X';             -- debugaccess
			av_address               : out std_logic_vector(15 downto 0);                    -- address
			av_write                 : out std_logic;                                        -- write
			av_readdata              : in  std_logic_vector(15 downto 0) := (others => 'X'); -- readdata
			av_writedata             : out std_logic_vector(15 downto 0);                    -- writedata
			av_read                  : out std_logic;                                        -- read
			av_begintransfer         : out std_logic;                                        -- begintransfer
			av_beginbursttransfer    : out std_logic;                                        -- beginbursttransfer
			av_burstcount            : out std_logic_vector(0 downto 0);                     -- burstcount
			av_byteenable            : out std_logic_vector(1 downto 0);                     -- byteenable
			av_readdatavalid         : in  std_logic                     := 'X';             -- readdatavalid
			av_waitrequest           : in  std_logic                     := 'X';             -- waitrequest
			av_writebyteenable       : out std_logic_vector(1 downto 0);                     -- writebyteenable
			av_lock                  : out std_logic;                                        -- lock
			av_chipselect            : out std_logic;                                        -- chipselect
			av_clken                 : out std_logic;                                        -- clken
			uav_clken                : in  std_logic                     := 'X';             -- clken
			av_debugaccess           : out std_logic;                                        -- debugaccess
			av_outputenable          : out std_logic;                                        -- outputenable
			uav_response             : out std_logic_vector(1 downto 0);                     -- response
			av_response              : in  std_logic_vector(1 downto 0)  := (others => 'X'); -- response
			uav_writeresponserequest : in  std_logic                     := 'X';             -- writeresponserequest
			uav_writeresponsevalid   : out std_logic;                                        -- writeresponsevalid
			av_writeresponserequest  : out std_logic;                                        -- writeresponserequest
			av_writeresponsevalid    : in  std_logic                     := 'X'              -- writeresponsevalid
		);
	end component integration_s4pu_cpu_avalon_slave_translator;

	component integration_rst_controller is
		generic (
			NUM_RESET_INPUTS        : integer := 6;
			OUTPUT_RESET_SYNC_EDGES : string  := "deassert";
			SYNC_DEPTH              : integer := 2;
			RESET_REQUEST_PRESENT   : integer := 0
		);
		port (
			reset_in0  : in  std_logic := 'X'; -- reset
			reset_in1  : in  std_logic := 'X'; -- reset
			clk        : in  std_logic := 'X'; -- clk
			reset_out  : out std_logic;        -- reset
			reset_req  : out std_logic;        -- reset_req
			reset_in2  : in  std_logic := 'X'; -- reset
			reset_in3  : in  std_logic := 'X'; -- reset
			reset_in4  : in  std_logic := 'X'; -- reset
			reset_in5  : in  std_logic := 'X'; -- reset
			reset_in6  : in  std_logic := 'X'; -- reset
			reset_in7  : in  std_logic := 'X'; -- reset
			reset_in8  : in  std_logic := 'X'; -- reset
			reset_in9  : in  std_logic := 'X'; -- reset
			reset_in10 : in  std_logic := 'X'; -- reset
			reset_in11 : in  std_logic := 'X'; -- reset
			reset_in12 : in  std_logic := 'X'; -- reset
			reset_in13 : in  std_logic := 'X'; -- reset
			reset_in14 : in  std_logic := 'X'; -- reset
			reset_in15 : in  std_logic := 'X'  -- reset
		);
	end component integration_rst_controller;

	component integration_rst_controller_001 is
		generic (
			NUM_RESET_INPUTS        : integer := 6;
			OUTPUT_RESET_SYNC_EDGES : string  := "deassert";
			SYNC_DEPTH              : integer := 2;
			RESET_REQUEST_PRESENT   : integer := 0
		);
		port (
			reset_in0  : in  std_logic := 'X'; -- reset
			clk        : in  std_logic := 'X'; -- clk
			reset_out  : out std_logic;        -- reset
			reset_req  : out std_logic;        -- reset_req
			reset_in1  : in  std_logic := 'X'; -- reset
			reset_in2  : in  std_logic := 'X'; -- reset
			reset_in3  : in  std_logic := 'X'; -- reset
			reset_in4  : in  std_logic := 'X'; -- reset
			reset_in5  : in  std_logic := 'X'; -- reset
			reset_in6  : in  std_logic := 'X'; -- reset
			reset_in7  : in  std_logic := 'X'; -- reset
			reset_in8  : in  std_logic := 'X'; -- reset
			reset_in9  : in  std_logic := 'X'; -- reset
			reset_in10 : in  std_logic := 'X'; -- reset
			reset_in11 : in  std_logic := 'X'; -- reset
			reset_in12 : in  std_logic := 'X'; -- reset
			reset_in13 : in  std_logic := 'X'; -- reset
			reset_in14 : in  std_logic := 'X'; -- reset
			reset_in15 : in  std_logic := 'X'  -- reset
		);
	end component integration_rst_controller_001;
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
