baioc/S4PU/(commit log)

2018-10-11 Initial commit
    R2: Read comments on main doc
    [FSM.xlsx, S4PU-16.smp_dump.txt, altera_onchip.psm, canonical.psm, composite.psm, embedded_v0.psm, fsm_v0.psm, onchip.psm]
2018-10-12 Added Simple Forth Assembler Python script
    Changed memory file to .mif format for simplicity
    Ran full processor simulation on ModelSim
    Updated docs
    [ISA.csv, embedded_v0.psm, fsm_v0.psm, syn.psm]
2018-10-25 DE2 prototipation ready
    Doc still unfinished with some cleanup to do on the quartus and project files
    [ISA.csv, S4PU-16.smp_dump.txt, embedded_v0.psm, nios2_computer.psm, stack_computer.psm, syn.psm]
2018-10-27 Prototype using University Program's EBAB
    Updated docs and decided not to go open-source for now
    Still running Fib benchmark on tests/simulation
    [ISA.csv, S4PU-16.smp_dump.txt, embedded_v0.psm, onchip_quartus_ram.psm, stack_computer.psm, worksheet.xlsx]
2018-11-01 Working DE2 physical prototipation!
    NOTE: Problems may arise when loading the project to the board with other computers, since the memory initialization file
    containing the Fib routine is found with different paths on each machine.
    Last run was through my own laptop.
    [S4PU-16.smp_dump.txt, embedded_v0.psm, nios2_computer.psm, onchip_quartus_ram.psm, stack_computer.psm]
2018-11-20 Working S4PU-Nios integration with Qsys! Docs finished, included last DE2 prototipation pictures. Daughterboard module is now used for the integration as an Avalon Slave connected to an internal dual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
    [ISA.csv, S4PU-16.smp_dump.txt, altera_onchip.psm, canonical.psm, composite.psm, embedded_v0.psm, fsm_v0.psm, nios2_computer.psm]
